Mashiyah/Preventing-Child-Drowning/Book/ProjectBook.pdf

# המרכז האקדמי רופין

## בית-הספר להנדסה המחלקה להנדסת חשמל ומחשבים

## ספר פרויקט גמר לשנת תשע"ט

## נושא הפרויקט:

# מערכת להצלת ילדים מטביעה

מבצעי הפרויקט:
נייד: 054-4929292
רן משיח
ran.mash@gmail.com | :מייל

נייד: 054-7280910
אלכסנדר גזל
sashagezel@gmail.com | :מייל

מנחה הפרויקט:

מר ברגמן אפרים

2

# המרכז האקדמי רופין

## בית-הספר להנדסה המחלקה להנדסת חשמל ומחשבים

## ספר פרויקט גמר לשנת תשע"ט

## נושא הפרויקט:

# מערכת להצלת ילדים מטביעה

הצהרה: העבודה המתוארת במסמך זה היא תוצאה של מחקר אישי שלי. כל טקסט או תוצאה שנלקחו והוכנסו לעבודה זו ממקורות אחרים מתועדים ככאלה. אני יודע/ת שאי עמידה בתנאים )של עבודה עצמית, וציטוט נאות של מקורות( היא עבירה על תקנון המשמעת של בית הספר העשויה לגרור צעדים משמעתיים בפני ועדת המשמעת.

חתימת הסטודנט | תאריך |
חתימת הסטודנט | תאריך |
חתימת המנחה | תאריך |

מבצעי הפרויקט:
נייד: 054-4929292
רן משיח
ran.mash@gmail.com | :מייל

נייד: 054-7280910
אלכסנדר גזל
sashagezel@gmail.com | :מייל

מנחה הפרויקט:

מר ברגמן אפרים

3

## מערכת להצלת ילדים מטביעה

תקציר

מקרי פגיעה ומוות כתוצאה מטביעה, בעיקר של תינוקות ושל ילדים, הפכו לשגרה עצובה בישראל ובעולם. טביעה הינה סיבת התמותה השנייה בשכיחותה בקרב ילדים. טביעות נגרמות בדרך כלל בהעדר השגחה, ואפילו לשניות בודדות. זה יכול לקרות בים או בבריכה.

בשל בעיה חשובה זו הוחלט לפתח מערכת המשלבת חומרה ותוכנה שתדע לזהות מקרה טביעה בקרב ילדים ותיתן מענה מהיר ונכון לצורך הצלת חיי הילד בעת טביעה. המערכת מיועדת לילדים בגילאים 0-8 שאינם יודעים לשחות ולא אמורים להיכנס למים ללא השגחת מבוגר.

המערכת אחראית לזיהוי הטביעה ולהפעלת המנגנונים השונים להצלת הילד במקרה הצורך. המערכת החשמלית כוללת מיקרו בקר, מנוע, מקור מתח, רכיב GSM וחיישנים שונים שינטרו את העומק בו נמצא הילד. כאשר הילד ימצא בעומק מסוים לפרק זמן שהוחלט מראש, המערכת החשמלית תפעיל מנגנונים שונים להצלת הילד.

מנגנון ראשון ודרישה עיקרית מהמערכת, היא היכולת להרים את ראשו של הילד מעל פני המים ולשמור עליו במצב זה. כאשר נענה לדרישה זו נמנע מגע של מים עם דרכי הנשימה שמוביל לחנק. מנגנון שני הוא שליחת הודעת חירום )SMS )למרכז בקרה, שם יתפעלו את האירוע, וישלחו הודעת SMS חזרה להורים. מנגנון זה עונה על הדרישה לקבלת תשומת לב של ההורים. בנוסף קיים גם כפתור לבדיקת תקינות המערכת. בתגובה ללחיצה תשלח הודעת SMS עם דוח תקינות מפורט.

בשלב היישום חוברו כל הרכיבים החשמליים למערכת אחת ונצרב קוד לארדואינו שמממש את הדרישות שהוגדרו. המערכת מזהה מגע עם מים באמצעות 2 פרובים כאשר הם מוכנסים למקור מים, בעקבות זאת המערכת נדלקת ומתחילה לעבד נתונים מהחיישן לחץ / עומק. באמצעות החיישן ניתן למדוד לחץ בדיוק של 0.01% ולחשב את הפרש העומק בו נמצא החיישן. המערכת מבצעת מדידה לחץ, ומתריעה על מצב טביעה ברגע שמתגלה עומק העולה על 10 ס"מ. ולאחר חציית הסף היא מפעילה טיימר של 2 שניות. אם במהלך הטיימר המערכת לא מזהה ירידה מהעומק שהוגדר, היא מפעילה מנוע DC שפותח את הווסת לשחרור ה - 2CO מחסנית ובכך לנפח את בלוני הציפה. המתח הנדרש להפעלת המנוע הוא V6 ולכן נעשה שימוש בממיר מתח, המעלה את מתח סוללת ה -LiPo למתח הדרוש. לאחר ניפוח בלוני הציפה, המערכת שולחת הודעה חירום למרכז בקרה. שליחת הודעות ה - SMS מתבצעת באמצעות רכיב התקשורת הסלולרית. בנוסף לבדיקת תקינות יזומה ע"י לחיצה על כפתור, המערכת מבצעת בדיקת תקינות אוטומטית לרכיבי המערכת בעת הדלקתה. לאחר בדיקת תקינות יזומה או אוטומטית נשלחת הודעת תקינות למרכז בקרה ובנוסף נדלק לד בצבע המתאים לתוצאת הבדיקה. נפח בלוני הציפה חושב באמצעות חוק ארכימדס.

לאחר בדיקות רבות וניסויים ניתן לומר כי המערכת מבצעת את הדרישות שהוגדרו בשלב התכנון. המערכת יודעת לזהות טביעה באחוז דיוק גבוה מאוד. צריכת המערכת הכוללת היא כ - mA 4.5 במצב שינה, וכ - mA15 כאשר המערכת נמצאת במגע עם מים. מכיוון שבמוצר הסופי יש הגבלה על גודל הסוללה, הוחלט כי המערכת תהיה כבויה עד אשר היא תורכב על צוואר הילד. היא תדלק באופן אוטומטי ברגע נעילת סוגר השרשרת. במקרה של תקציב גדול יותר ניתן היה להגיע למוצר מוגמר שניתן יהיה להלביש על הילד.

4

## מערכת להצלת ילדים מטביעה

תוכן עניינים

.1 הקדמה 6 |
.2 סקר ספרות7 |
.2.1 ארדואינו7 |
7 | UART .2.2
C | תקשורת | .2.3 ² 8 | I
9 | GSM .2.4
.2.5 רמת אטימות IP9 |
.2.6 חוק ארכימדס10 |
.2.7 לחץ אטמוספרי11 |
.2.8 בלוני ציפה11 |
.2.9 נפח בלוני ציפה12 |
.2.10 משוואת הגז האידיאלי 13 |
.2.11 פחמן דו חמצני )2CO )14 |
.3.1 דרישות עיקריות 15 |
.3.2 תיאור המערכת17 |
.3.3 מבנה הקוד )אלגוריתם(26 |
.3.4 אתגרים במימוש 30 |
.4.1 המערכת מבצעת בדיקת תקינות כללית לאחר הדלקתה32 |
.4.2 הפעלת פסיקה לבדיקת תקינות המערכת לאחר לחיצה על הכפתור33 |
.4.3 זיהוי מגע עם מים35 |
.4.4 קבלה ועיבוד נתונים מחיישן העומק36 |
.4.5 זיהוי מצב טביעה 37 |
.4.6 ניפוח בלוני ציפה כמנגנון ראשון להצלת התינוק / ילד38 |
.4.7 שליחת הודעות חירום כמנגנון שני להצלת התינוק / ילד39 |
.5.1 תוצאות והישגים40 |
.5.2 המלצות להמשך40 |
42 | ABSTRACT .7
.8.1 נספח :1 קוד המערכת43 |
.8.2 נספח :2 בדיקות המערכת )STD )53 |
.8.3 נספח :3ניהול סיכונים56 |
.8.4 נספח :4גאנט 59 |

5

רשימת תמונות ואיורים

תמונה 1 - חוט TX של UART אחד מתחבר לחוט RX של השני ולהפך. (https://ruppin365-my.sharepoint.com/personal/ran_messia_ruppin365_net/Documents/פרוייקט%20גמר/Final/ProjectBook.docx) 7 | (https://ruppin365-my.sharepoint.com/personal/ran_messia_ruppin365_net/Documents/פרוייקט%20גמר/Final/ProjectBook.docx)
תמונה 2 - UART המשדר בייט מידע (https://ruppin365-my.sharepoint.com/personal/ran_messia_ruppin365_net/Documents/פרוייקט%20גמר/Final/ProjectBook.docx) 7 | (https://ruppin365-my.sharepoint.com/personal/ran_messia_ruppin365_net/Documents/פרוייקט%20גמר/Final/ProjectBook.docx)
8 | I

תמונה 3 - תיאור של אפיק C² (https://ruppin365-my.sharepoint.com/personal/ran_messia_ruppin365_net/Documents/פרוייקט%20גמר/Final/ProjectBook.docx)
תמונה 4 - דרגות ההגנה שמספקות מעטפות (https://ruppin365-my.sharepoint.com/personal/ran_messia_ruppin365_net/Documents/פרוייקט%20גמר/Final/ProjectBook.docx) 9 | (https://ruppin365-my.sharepoint.com/personal/ran_messia_ruppin365_net/Documents/פרוייקט%20גמר/Final/ProjectBook.docx)
תמונה 6 - טווח משקלים של תינוקות וילדים מגיל 5 עד 10 (https://ruppin365-my.sharepoint.com/personal/ran_messia_ruppin365_net/Documents/פרוייקט%20גמר/Final/ProjectBook.docx) 12 | (https://ruppin365-my.sharepoint.com/personal/ran_messia_ruppin365_net/Documents/פרוייקט%20גמר/Final/ProjectBook.docx)
תמונה 7 - תכונות הפחמן הדו חמצני (https://ruppin365-my.sharepoint.com/personal/ran_messia_ruppin365_net/Documents/פרוייקט%20גמר/Final/ProjectBook.docx) 14 | (https://ruppin365-my.sharepoint.com/personal/ran_messia_ruppin365_net/Documents/פרוייקט%20גמר/Final/ProjectBook.docx)
תמונה 8 - מחסנית 2CO 16 גרם14 | (https://ruppin365-my.sharepoint.com/personal/ran_messia_ruppin365_net/Documents/פרוייקט%20גמר/Final/ProjectBook.docx)
תמונה 9 - מבנה חיצוני (https://ruppin365-my.sharepoint.com/personal/ran_messia_ruppin365_net/Documents/פרוייקט%20גמר/Final/ProjectBook.docx) 17 | (https://ruppin365-my.sharepoint.com/personal/ran_messia_ruppin365_net/Documents/פרוייקט%20גמר/Final/ProjectBook.docx)
תמונה 10 - ארכיטקטורה פנימית (https://ruppin365-my.sharepoint.com/personal/ran_messia_ruppin365_net/Documents/פרוייקט%20גמר/Final/ProjectBook.docx) 18 | (https://ruppin365-my.sharepoint.com/personal/ran_messia_ruppin365_net/Documents/פרוייקט%20גמר/Final/ProjectBook.docx)
19 | ARDUINO PRO MINI - 11 | תמונה (https://ruppin365-my.sharepoint.com/personal/ran_messia_ruppin365_net/Documents/פרוייקט%20גמר/Final/ProjectBook.docx)
20 | MS5803-14BA - 12 | תמונה (https://ruppin365-my.sharepoint.com/personal/ran_messia_ruppin365_net/Documents/פרוייקט%20גמר/Final/ProjectBook.docx)
21 | MINI GEARED DC MOTOR 6V - 13 | תמונה (https://ruppin365-my.sharepoint.com/personal/ran_messia_ruppin365_net/Documents/פרוייקט%20גמר/Final/ProjectBook.docx)
תמונה 14 - בקר מנוע DC FNG6612TB (https://ruppin365-my.sharepoint.com/personal/ran_messia_ruppin365_net/Documents/פרוייקט%20גמר/Final/ProjectBook.docx) 22 | (https://ruppin365-my.sharepoint.com/personal/ran_messia_ruppin365_net/Documents/פרוייקט%20גמר/Final/ProjectBook.docx)
22 | SIM800L - 15 | תמונה (https://ruppin365-my.sharepoint.com/personal/ran_messia_ruppin365_net/Documents/פרוייקט%20גמר/Final/ProjectBook.docx)
23 | DC/DC BOOST CONVERTER + CHARGER - 16 | תמונה (https://ruppin365-my.sharepoint.com/personal/ran_messia_ruppin365_net/Documents/פרוייקט%20גמר/Final/ProjectBook.docx)
תמונה 17 - סוללת LIPO V23 | 3.7 (https://ruppin365-my.sharepoint.com/personal/ran_messia_ruppin365_net/Documents/פרוייקט%20גמר/Final/ProjectBook.docx)
תמונה 18 - טעינה אלחוטית24 | (https://ruppin365-my.sharepoint.com/personal/ran_messia_ruppin365_net/Documents/פרוייקט%20גמר/Final/ProjectBook.docx)
תמונה 19 - המערכת מבצעת בדיקת תקינות כללית לאחר הדלקתה - תקין32 | (https://ruppin365-my.sharepoint.com/personal/ran_messia_ruppin365_net/Documents/פרוייקט%20גמר/Final/ProjectBook.docx)
תמונה 20 - קבלת הודעת SMS למרכז בקרה שהכל תקין33 | (https://ruppin365-my.sharepoint.com/personal/ran_messia_ruppin365_net/Documents/פרוייקט%20גמר/Final/ProjectBook.docx)
תמונה 21 - המערכת מבצעת בדיקת תקינות כללית לאחר הדלקתה - לא תקין (https://ruppin365-my.sharepoint.com/personal/ran_messia_ruppin365_net/Documents/פרוייקט%20גמר/Final/ProjectBook.docx) 33 | (https://ruppin365-my.sharepoint.com/personal/ran_messia_ruppin365_net/Documents/פרוייקט%20גמר/Final/ProjectBook.docx)
תמונה 22 - בדיקת תקינות המערכת לאחר לחיצה על הכפתור (https://ruppin365-my.sharepoint.com/personal/ran_messia_ruppin365_net/Documents/פרוייקט%20גמר/Final/ProjectBook.docx) 34 | (https://ruppin365-my.sharepoint.com/personal/ran_messia_ruppin365_net/Documents/פרוייקט%20גמר/Final/ProjectBook.docx)
תמונה 23 - הודעת SMS לאחר לחיצה על הכפתור הבדיקות34 | (https://ruppin365-my.sharepoint.com/personal/ran_messia_ruppin365_net/Documents/פרוייקט%20גמר/Final/ProjectBook.docx)
תמונה 24 - זיהוי מגע עם מים35 | (https://ruppin365-my.sharepoint.com/personal/ran_messia_ruppin365_net/Documents/פרוייקט%20גמר/Final/ProjectBook.docx)
תמונה 25 - קבלה ועיבוד נתונים מחיישן העומק (https://ruppin365-my.sharepoint.com/personal/ran_messia_ruppin365_net/Documents/פרוייקט%20גמר/Final/ProjectBook.docx) 36 | (https://ruppin365-my.sharepoint.com/personal/ran_messia_ruppin365_net/Documents/פרוייקט%20גמר/Final/ProjectBook.docx)
תמונה 26 - זיהוי מצב טביעה לאחר שנגמר הטיימר37 | (https://ruppin365-my.sharepoint.com/personal/ran_messia_ruppin365_net/Documents/פרוייקט%20גמר/Final/ProjectBook.docx)
תמונה 27 - ניפוח בלוני ציפה כמנגנון ראשון להצלת התינוק / ילד38 | (https://ruppin365-my.sharepoint.com/personal/ran_messia_ruppin365_net/Documents/פרוייקט%20גמר/Final/ProjectBook.docx)
תמונה 28 - שליחת הודעות חירום כמנגנון שני להצלת התינוק / ילד39 | (https://ruppin365-my.sharepoint.com/personal/ran_messia_ruppin365_net/Documents/פרוייקט%20גמר/Final/ProjectBook.docx)
תמונה 29 - הודעות החירום המתקבלות (https://ruppin365-my.sharepoint.com/personal/ran_messia_ruppin365_net/Documents/פרוייקט%20גמר/Final/ProjectBook.docx) 39 | (https://ruppin365-my.sharepoint.com/personal/ran_messia_ruppin365_net/Documents/פרוייקט%20גמר/Final/ProjectBook.docx)

רשימת טבלאות

טבלה 1 - גיל, משקל ממוצע ונפח הבלון הדרוש13 |
טבלה 2 - צפיפות לפי סוג החומר13 |
טבלה 3 - מאפייני המיקרו בקר מתוך דף המפרט (https://ruppin365-my.sharepoint.com/personal/ran_messia_ruppin365_net/Documents/פרוייקט%20גמר/Final/ProjectBook.docx) 19 | (https://ruppin365-my.sharepoint.com/personal/ran_messia_ruppin365_net/Documents/פרוייקט%20גמר/Final/ProjectBook.docx)
טבלה 4 - מאפייני החיישן מתוך דף המפרט20 | (https://ruppin365-my.sharepoint.com/personal/ran_messia_ruppin365_net/Documents/פרוייקט%20גמר/Final/ProjectBook.docx)
טבלה 5 - מאפייני המנוע מתוך דף המפרט21 | (https://ruppin365-my.sharepoint.com/personal/ran_messia_ruppin365_net/Documents/פרוייקט%20גמר/Final/ProjectBook.docx)
טבלה 6 - מאפייני בקר המנוע מתוך דף המפרט22 | (https://ruppin365-my.sharepoint.com/personal/ran_messia_ruppin365_net/Documents/פרוייקט%20גמר/Final/ProjectBook.docx)
טבלה 7 - מאפייני רכיב ה - GSM מתוך דף המפרט22 | (https://ruppin365-my.sharepoint.com/personal/ran_messia_ruppin365_net/Documents/פרוייקט%20גמר/Final/ProjectBook.docx)
טבלה 8 - מאפייני רכיב ה ממיר מתח + מטען סוללות מתוך דף המפרט23 | (https://ruppin365-my.sharepoint.com/personal/ran_messia_ruppin365_net/Documents/פרוייקט%20גמר/Final/ProjectBook.docx)

רשימת משוואות

משוואה 1 - כוח העילוי10 |
משוואה 2 - הכוח השקול על גוף10 |
משוואה 3 - משוואת הגזים האידאלי 13 |
משוואה 4 - נפח הגז הנפלט ממחסנית 16 גרם14 |
משוואה 5 - חישוב שינוי בגובה30 |

6

.1 הקדמה

טביעה מכונה "המוות השקט", היא מתרחשת במהירות ובדממה ובדרך כלל לא שומעים בכי או צעקות מצוקה. מקרי פגיעה ומוות כתוצאה מ"המוות השקט", בעיקר של תינוקות ושל ילדים, הפכו
1 | לשגרה עצובה בישראל ובעולם. טביעה הינה סיבת התמותה השנייה בשכיחותה בקרב ילדים
כשליש ממקרי הטביעה שהסתיימו במוות, היו של ילדים בגילי .4-0 מאז שנת 2008 מתו בישראל .

מעל 210 ילדים עקב טביעה²

מקובל לחשוב כי טביעות מתרחשות רק במים עמוקים, אך למעשה מרבית הטביעות נגרמות בלי קשר לעומק המים. גם בגובה עשרה סנטימטר ילד יכול לטבוע, אם פיו ואפו נמצאים מתחת לפני המים. אצל ילדים ולעיתים גם אצל מבוגרים, מגע של מים עם דרכי הנשימה מוביל להתכווצות של שרירי הלוע, דבר שבעצמו סוגר את דרכי הנשימה ומוביל לחנק.

הנזק העיקרי מטביעה הוא המחסור בחמצן - מצב המכונה היפוקסמיה. מצב זה גורם לנזק לכל רקמות הגוף, אולם רקמת המוח רגישה במיוחד למחסור בחמצן ולכן, הנזק המוחי הוא הגורם העיקרי לתחלואה ולתמותה כתוצאה מטביעה.

טביעות נגרמות בדרך כלל בהעדר השגחה, ואפילו לשניות בודדות. זה יכול לקרות בים, בבריכה העירונית, בבריכה הפרטית בבית, או במלון. נמצא כי תשעה מכל עשרה מקרי טביעה של ילדים התרחשו כשההורים היו בקרבת ילדיהם ולעיתים אף צמודים להם ממש.

למרות אמצעי הבטיחות הקיימים למניעת טביעות ומקרי מוות בקרב תינוקות וילדים, מקרים אלו נעשו שכיחים יותר מאשר בעבר. בשל בעיה חשובה זו הוחלט לפתח מערכת המשלבת חומרה ותוכנה שתדע לזהות מקרה טביעה בקרב ילדים ותיתן מענה מהיר ונכון לצורך הצלת חיי הילד בעת טביעה.

משרד הבריאות - בטיחות ילדים במים ומניעת טביעה | 1
היפגעות ילדים בישראל: דו"ח 'בטרם' לאומה 2017 | 2

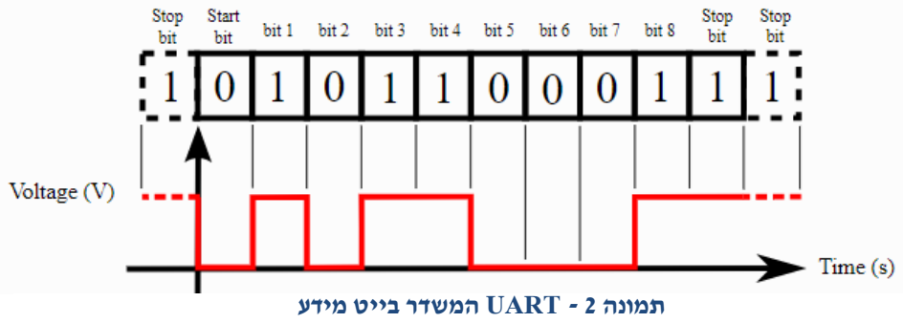
[picture p22: figure]
תמונה 2 - UART המשדר בייט מידע

7

.2 סקר ספרות

.2.1 ארדואינו

אַ רְ דּואִ ינֹו )מאיטלקית: Arduino )הוא מיקרו-בקר בעל מעגל מודפס יחיד, עם סביבת פיתוח משולבת )IDE )ברישיון קוד פתוח, אשר מטרתה ליצור סביבה נוחה וזולה לפיתוח פרויקטים המשלבים תוכנה עם רכיבי אלקטרוניקה.

רכיב החומרה העיקרי על המעגל המודפס של הארדואינו הוא מיקרו בקר בן 8 סיביות מסדרת AVR של חברת ATMEL, אשר מבצע את התוכנה ומכיל זיכרון הבזק )FlashMemory )לאחסונה. לארדואינו גרסאות חומרה שונות למטרות שונות. הוא מגיע בגדלים שונים, מתחי עבודה שונים וגם תדר שעון שונה.

לארדואינו יש את היכולת לתקשר עם רכיבים חיצוניים ומודולים באמצעות פרוטוקולים סטנדרטיים שהופכים את התקשורת לפשוטה ואמינה ויותר - פרוטוקולים SPI, C2I ו-UART.

UART .2.2

UART( מבוטא "יּו - אַ רט"( הוא פרוטוקול תקשורת נפוץ לתקשורת טורית אסינכרונית. מקור השם באנגלית בראשי תיבות של Receiver Asynchronous Universal Transmitter, ובעברית "מקלט משדר אסינכרוני אוניברסלי" שהתייחס אל השבב אשר מימש את פרוטוקול התקשורת הטורית. מערכות רבות מממשות את הפרוטוקול כחלק ממעגל משולב או בתוך רכיב מתכנת. הפרוטוקול מאפשר תקשורת טורית עם 2 חוטים בלבד )Tx ו - Rx) הפרוטוקול נותן שליטה על מספר פרמטרים כמו קצב העברת הנתונים, כמות סיביות המידע בכל, הוספת סיבית זוגיות ומשך סימבול הסיום.

תמונה 1 - חוט TX של UART אחד מתחבר לחוט RX של השני ולהפך.

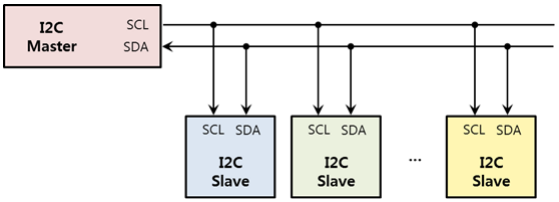
[picture p23: figure]

8

C | תקשורת | .2.3 ² I
C-BUS או , | אפיק ² C - Circuit Integrated-Inter( I

2
I(, ידוע גם בשם "ממשק שני-
מוליכים" הוא ממשק תקשורת טורית )סריאלי( המורכב משני מוליכים. הממשק נועד, במקורו, להעברת נתונים בין רכיבים במעגלים מוכללים שהותקנו במכשירי רדיו וטלויזיה. כיום, השימוש העיקרי באפיק זה הוא כממשק תקשורת בין מיקרו-מעבד )או מיקרו-בקר( לבין רכיבי קצה. מהירויות העבודה האופייניות של הרכיב הן kbps .100-3400
2 | תקן )פרוטוקול( C
I מגדיר את נוהל התקשורת בין הרכיבים המחוברים לאפיק, לרבות

תדר שידור המידע )data), תזמון התקשורת בין הרכיבים ומבנה יחידת המידע המשודרת. שני המוליכים באפיק הם דו-כיווניים ולכל אחד מהם תפקיד מוגדר:

- קו מידע )SDA-DataSerial )שנועד להעברת מידע בין רכיבים. כל אחד מהרכיבים המחוברים לאפיק זה יכול לשמש כמשדר או כמקלט.
- קו שעון )SCL-ClockSerial )שנועד לסנכרן את המידע העובר בין רכיבים.

יחידת המידע הבסיסית המשודרת מרכיב לרכיב היא מילה באורך של 8 סיביות. לכל אחד מהרכיבים המחוברים לאפיק משויכת כתובת הנקבעת על-ידי סוג הרכיב המחובר )מיקרו-בקר, חיישן, התקן זיכרון(.

התקן מגדיר שני סוגי רכיבים שניתן לחבר לאפיק רכיבי MASTER ורכיבי SLAVE.

רכיב MASTER מוגדר כרכיב שיוזם את התקשורת ומספק את אות השעון. הרכיב שאליו

פונה ה - MASTER מוגדר כרכיב ה - SLAVE. בדרך כלל ה - MASTER הוא מיקרו-

בקר )או מיקרו-מעבד(, בעוד שה - SLAVE הוא רכיב קצה כדוגמת, חיישן, רכיב תצוגה, התקן זיכרון וממיר ספרתי לאנלוגי.

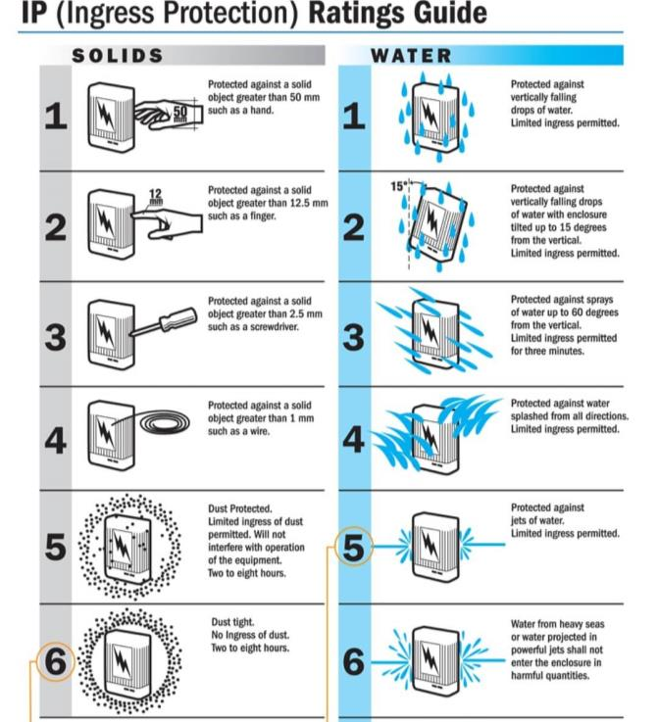
[picture p24: figure]

9

תמונה 4 - דרגות ההגנה שמספקות מעטפות

GSM .2.4

תקשורת | לרשתות | תקן | הוא | Global System for Mobile Communications או GSM
סלולרית. רשתות אלו הן הנפוצות ביותר בעולם. ב־2010 היו בעולם כחמישה מיליארד מנויי GSM.

GSM עושה שימוש בטכנולוגית גישה מרובה מבוססת זמן, Multiple Division Time Access. הקול מועבר באופן דיגיטלי ולכן רשתות GSM מקוטלגות כ-"דור שני". הרשת הבסיסית שמותאמת לשיחות קוליות בלבד הורחבה באמצעות שתי טכנולוגיות משלימות להעברת נתונים: GPRS ו-EDGE. טכנולוגיות אלו מכונות "דור 2.5" ו-"דור 2.75" בהתאמה.

GSM תומך בטווח רחב של תדרים. באופן כללי בטווח שבין MHz 260 ל- MHz .1900 GSM מגדיר לא רק את ממשק השיחה אלא את התשתית כולה, זאת כדי לאפשר תאימות בין יצרנים שונים וכן לאפשר ממסר בין תחנות ונדידה - קבלת שירות עבור המכשיר או כרטיס ה-SIM בין מדינות שונות.

.2.5 רמת אטימות IP

רמת אטימות IP( גם דרגת IP (קיצור שלMarking Protection International היא סיווג של מידת ההגנה והאטימות של מכשיר מסוים מפני חלקיקים )אבק( ומפני מים. הסיווג מורכב מצמד האותיות האנגליות IP ומשתי ספרות, המוגדרות על ידי תקן 60529 IEC של הנציבות הבינלאומית לאלקטרוטכניקה.

הספרה הראשונה מציינת הגנה נגד מגע מקרי או מגע רשלני בחלקים חיים או נעים בתוך המעטפת וגם חדירת גופים מוצקים לתוך המעטפת. הספרה שנייה מציינת את דרגת הגנה מפני חדירת מים, דרך המעטפת.

לדוגמא:
68IP מציין הגנה מוחלטת מפני חדירת אבק ובנוסף הגנה בפני חדירת מים בעת ממושכת,
בתנאים שפרט היצרן.

10

.2.6 חוק ארכימדס

כאשר גוף נמצא בנוזל, הוא עשוי לצוף על פני הנוזל או לשקוע בתוכו. החוק מראה כי הגוף צף אם הצפיפות שלו ) היחס בין מסתו לנפחו ( קטנה מזו של הנוזל . אם הצפיפות של הגוף גדולה מצפיפות הנוזל, הגוף שוקע. אם הצפיפויות שוות, הגוף ירחף בנוזל, כלומר ישהה בגובה שבו נשים אותו.

קל להסביר את הממצאים הללו בעזרת תכונות הלחץ ההידרוסטטי. כאשר הגוף נמצא בתוך הנוזל פועל עליו לחץ הידורו סטטי מכל הצדדים. אולם מכיוון שהלחץ גדל עם העומק, הלחץ ההידרוסטטי על צידו התחתון של הגוף גדול יותר מאשר על צידו העליון. לכן פועל על הגוף כוח שקול בכיוון מעלה, המכונה כוח עילוי .

את גודלו של כוח העילוי נחשב כך: נניח שאת מקום הגוף הייתה תופסת כמות של נוזל, שנפחה וצורתה זהים לאלה של הגוף. הנוזל מסביב היה מפעיל עליה כוחות זהים לאלה שהוא מפעיל על הגוף. מכיוון שכמות הנוזל הייתה נמצאת במנוחה, אפשר להסיק כי השקול של הכוחות הללו שווה בגודלו למשקל של כמות הנוזל, שהוא כידוע כוח בגודל, mg שכיוונו כלפי מטה. מכאן שכוח העילוי על הגוף הוא, mg כאשר m היא המסה של כמות נוזל, שנפחה שווה לנפח הגוף. אם נפח הגוף הוא, V וצפיפות הנוזל היא ρ , נקבל Vρ = m כוח העילוי נתון לכן על ידי: F = Vρg

כאשר V הוא נפח הגוף ו - ρ היא צפיפות הנוזל.

ארכימדס, שחי במאה השלישית לפנה"ס, גילה חוק זה לראשונה וניסח אותו כך: ''על גוף השקוע בנוזל פועל כוח עילוי השווה למשקל הנוזל שנדחה על ידי הגוף. ''

עלינו לזכור כי על הגוף פועל גם משקלו שלו , ולכן הכוח השקול הוא: ∑F = Vρg − Vρ
′g = Vg − Vg(ρ − ρ

′
)

ρ היא צפיפות הנוזל ו ′ρ היא צפיפות הגוף.

אם ρ > ′ρ, כוח העילוי גובר על המשקל והכוח השקול מכוון כלפי מעלה. הגוף יצוף עד שחלקו יבצבץ מהמים, באופן שכוח העילוי על החלק השקוע יאזן את משקל הגוף כולו. אם ρ < ′ρ, המשקל גובר על כוח העילוי והגוף ישקע עד לקרקעית.

אם ρ = ′ρ, כוח העילוי שווה למשקל והגוף ירחף.

משוואה 1 - כוח העילוי

משוואה 2 - הכוח השקול על גוף

11

.2.7 לחץ אטמוספרי

לעיתים נקרא גם לחץ ברומטרי הוא הלחץ, שמפעיל האוויר באטמוספירה של כדור הארץ. גודלו של הלחץ האטמוספירי הממוצע בגובה פני הים הוא:

בקירוב, ניתן לומר, כי הלחץ האטמוספירי שקול ללחץ ההידרוסטטי, שמפעיל עמוד האוויר מעל כל נקודה בכדור הארץ. כך, מעל אזורי לחץ נמוך עמוד האוויר נמוך יותר מאשר באזורי לחץ גבוה. באופן דומה, ניתן להבין מדוע לחץ האוויר יורד, ככל שעולים גבוה יותר מעל פני הים.

הבדלים בלחץ האוויר נוצרים מהבדלים בקרינת השמש, בגובה ובקו הרוחב של האזור. המכשיר המודד לחץ אוויר נקרא ברומטר, ויחידות המידה בהן משתמשים למטרה זו הן מ"מ כספית (Hmm) או בר (ab) או אטמוספירה (TA)

.2.8 בלוני ציפה

רוב יצרני סירות הגומי או אביזרים מתנפחים מייצרים את סירותיהם מבד ניילון מצופה פוליאוריתן )TPU). שילוב חומרים זה חזק, אטום לאוויר, עמיד למים, עמיד בפני קרינה אּולְטְ רָ ה סגולה, אינו נמתח הרבה ושומר על חוזקו גם בטמפרטורות נמוכות מאוד.

פוליאוריתן תרמו-פלסטי )TPU )הוא גרסה של PU הנקשרת לעצמה כשהיא מחוממת עם אקדח ברזל או אוויר חם. זה יוצר קשר חזק מאוד וקבוע, ומבטל את הצורך בתפירה או הדבקה.

אחת הדרכים לסיווג הבד היא על ידי (D" (denier", שהוא מדד למשקל החוט, כאשר denier אחד שווה למשקל של חוט משי בודד, ומספרים של denier גבוהים יותר מציינים חוט כבד יותר )ולכן עבה וחזק יותר(. הקשר בין מספר denier למשקל וחוזק הבד אינו לינארי.

לאחר קריאה ממושכת באינטרנט מצאנו כי עובי הבד הנכון לשימוש הוא D210 כיוון שהוא ממש קל, מאפשר לקפל אותו, לא יקרע / ינוקב בקלות ומשתמשים בו רבות באביזרי ציפה למיניהם.

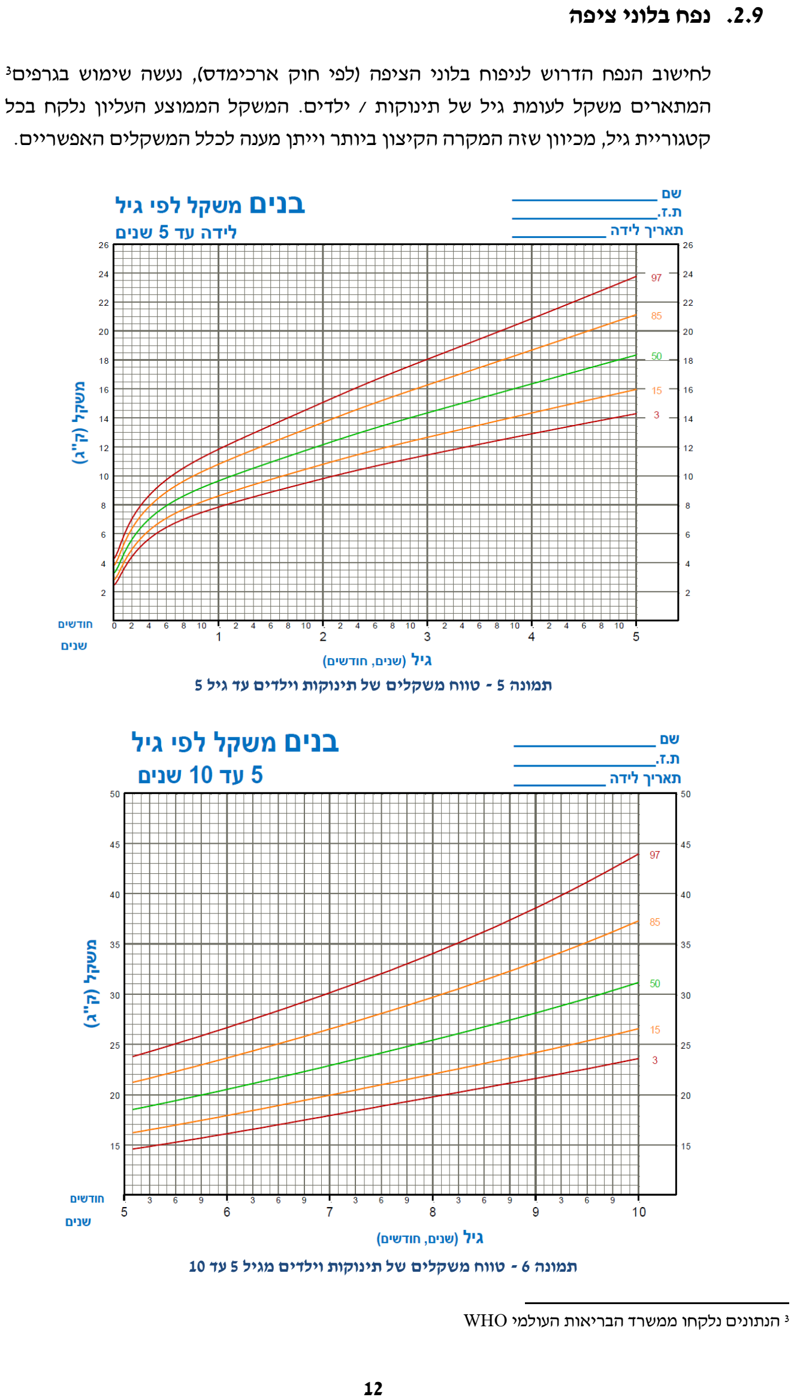
[picture p25: page 12]

12

.2.9 נפח בלוני ציפה

3 | לחישוב הנפח הדרוש לניפוח בלוני הציפה )לפי חוק ארכימדס(, נעשה שימוש בגרפים
המתארים משקל לעומת גיל של תינוקות / ילדים. המשקל הממוצע העליון נלקח בכל קטגוריית גיל, מכיוון שזה המקרה הקיצון ביותר וייתן מענה לכלל המשקלים האפשריים.
הנתונים נלקחו ממשרד הבריאות העולמי WHO | 3

תמונה 5 - טווח משקלים של תינוקות וילדים עד גיל 5

תמונה 6 - טווח משקלים של תינוקות וילדים מגיל 5 עד 10

13

מגרפים הנ"ל ניתן לבנות את הטבלה הבאה:

נפח הבלון הדרוש )2 הבלונים ביחד( | משקל ממוצע )ק"ג, קיצון עליון( | גיל )שנים(
0.52 | 11.8 | 1
0.72 | 15 | 2
0.86 | 18 | 3
0.99 | 20.8 | 4
1.15 | 24 | 5
1.28 | 26.8 | 6
1.43 | 30 | 7
1.62 | 34 | 8
טבלה 1 - גיל, משקל ממוצע ונפח הבלון הדרוש

לחישוב נפח הבלון הדרוש נעשה שימוש בנוסחת ארכימדס )משוואה 2( ובנתונים הבאים:

.2.10 משוואת הגז האידיאלי

גז אידאלי הינו גז אשר מורכב ממולקולות נקודתיות בעלי נפח זניח, שאינן מגיבות זו עם זו. הנחה זו הינה הכרחית לחישובים פשוטים של טמפרטורה, לחץ ונפח הגז. משוואת הגז האידאלי מורכבת משלושה חוקים חשובים: חוק בויל, חוק צ'ארלס וחוק הגז המשולב. שלושת החוקים הללו מגדירים את הקשר בין נפח, לחץ וטמפרטורה של הגז.

חוק בויל מגדיר את הקשר בין לחץ לנפח. ככל שהנפח גדל, הלחץ קטן משום שההסתברות של מולקולות הגז להתנגש בדפנות הכלי יורד. חוק צ'ארלס מגדיר את הקשר בין טמפרטורה לנפח. ככל שהטמפרטורה עולה, גם הנפח עולה, משום שמולקולות הגז מקבלות אנרגית חום המתורגמת לאנרגיה קינטית הגורמת להן לנוע מהר יותר, והלחץ גדל. כאשר הלחץ גדל, הוא מאפשר את הגדלת הנפח על חשבון הלחץ. חוק הגז המשולב משלב בין שני החוקים הנ"ל ומראה את יחסי הגומלין בין טמפרטורה, לחץ ונפח. וחוק הגזים האידאליים מכניס את החוקים הללו למשוואה:

V =

nRT
P

כאשר P - לחץ, T - טמפ', V - נפח, R - קבוע הגזים ) 0.082

L×atm
K×mol

(, n - מספר המולים

Human Body Density and Fat ⁴ The American Journal of Clinical Nutrition -

| סוג חומר צפיפות
g cm³ | מי בריכה 1
g cm³ | מי ים 1.03
g 40.985 cm³ | גוף האדם

טבלה 2 - צפיפות לפי סוג החומר

משוואה 3 - משוואת הגזים האידאלי

14

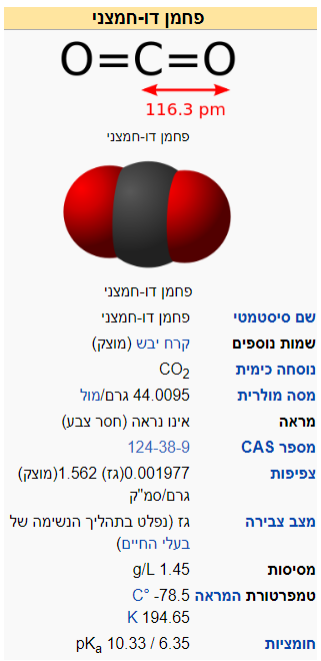
[picture p26: figure]

תמונה 7 - תכונות הפחמן הדו חמצני

.2.11 פחמן דו חמצני )2CO)

פחמן דו חמצני, נקרא גם דו-תחמוצת הפחמן, הוא גז )בטמפרטורת החדר( המהווה תרכובת של פחמן וחמצן. כל מולקולה שלו מורכבת מאטום פחמן אחד ושני אטומי חמצן, הקשורים אליו בקשר קוולנטי כפול. זהו גז חסר צבע אשר מצב הצבירה שלו קרוי קרח יבש, בזכות תכונת ההמראה המאפיינת אותו, כלומר מעבר ישיר ממצב מוצק למצב גז.
. שכיחותו באטמוספירה נמוכה - רק 0.035 | 5 | בעל מסה מולרית של 44.0095 גרם/מול
אחוזים. פחמן דו חמצני הוא התחמוצת המצויה ביותר בעולם.

לצורך מילוי בלוני הציפה, נדרש גז שניתן לאחסן ולטפל בו בקלות. כמו כן, הוא חייב להיות בטוח לשימוש ולא נפיץ. לאחר סקירת ספרות בחרנו בפחמן דו חמצני כגז שימלא את בלוני הציפה מכיוון שצפיפותו היא מאוד נמוכה ביחס לגזים האחרים. בנוסף זה גז שמאוכסן במחסנית במצב נוזל, ככה שבעת שחרורו הוא תופס הרבה יותר נפח כגז.

מחסניות ה - 2CO משמשות למגוון רחב של שימושים כגון: נשקי איירסופט / פיינטבול, ניפוח בלוני ציפה בעלי נפח משתנה וכל המשקאות המוגזים כגון סודה-סטרים.

לחישוב כמות הגז המשתחררת בעת פתיחת המחסנית משתמשים במשוואת הגז האידיאלי. לדוגמא עבור מחסנית 2CO בגודל 16 גרם נקבל:

V =

nRT
P

=

16
44.0095 × 0.082 × 295.4
1.06351 | = 8.2[L]

כאשר T הוא הטמפ' הממוצעת השנתית בים ו - P הוא הלחץ בעומק 0.5 מטר.

5

מול )Mole )הוא יחידת מידה סטנדרטית המגדירה כמות חומר על פי מספר חלקיקים קבוע.

תמונה 8 - מחסנית 2CO 16 גרם

משוואה 4 - נפח הגז הנפלט ממחסנית 16 גרם

15

.3 תכנון הנדסי

.3.1 דרישות עיקריות

דרישה עיקרית מהמערכת, היא היכולת להרים את ראשו של הילד מעל פני המים ולשמור עליו במצב זה. כאשר יינתן מענה לדרישה זו יימנע מגע של מים עם דרכי הנשימה שמוביל לחנק.

דרישה זו נובעת בגלל שראשם של תינוקות וילדים עד גיל 5 כבד יותר משאר חלקי הגוף. זאת הסיבה שילדים מתהפכים ונותרים עם הראש בתוך המים, מבלי יכולת עצמאית להתהפך. אם פיו ואפו של הילד נמצאים מתחת לפני המים לזמן של שתי דקות הוא עלול לאבד את הכרתו, ולאחר מכן קיים סיכון של נזק מוחי בלתי הפיך ועד למוות.

דרישה עיקרית נוספת מהמערכת היא שליחת הודעת SMS להורים על ידי מרכז בקרה, לקבלת תשומת הלב שלהם. דרישה זו נובעת מכיוון שהסיבה העיקרית לטביעת תינוקות וילדים היא העדר השגחה או נתק קצר בהשגחה. יש גורמים רבים המסיחים את דעת ההורים ופוגעים במידת השגחתם על ילדיהם, כמו קריאה, שיחה עם אנשים וכמובן גם שימוש בטלפונים ניידים.

.3.1.1 דרישות ספציפיות

דרישות חיצוניות - המערכת כולה צריכה להיות קלה ונוחה לשימוש מכיוון שמדובר בפריט לביש שמיועד לשבת על צוואר הילד. מכך עולה הדרישה להשתמש בחומרים קלים שלא יכבידו על צוואר הילד. בנוסף החומרים צריכים להיות עמידים למים וכמובן לשימוש הילדים והורים. בנוסף המערכת מיועדת להיות במגע עם מים בעת שימוש, באזורי בריכה או ים, לכן קיימת דרישה שהמערכת החשמלית תהיה במארז עמיד למים )67IP). מארז זה יתן גם מענה לתנאי מזג אוויר קיצוניים אשר עלולים להשפיע על החומרה ולפגוע בה.

דרישות פנימיות - המערכת החשמלית חייבת להיות כמה שיותר אמינה ולפעול עם כמה שפחות תקלות. כלומר צריך לבחור רכיבים חשמליים שהוכיחו את אמינותם ודיוקם בפרויקטים אחרים ובשוק הכללי. רכיבי המערכת החשמלית צריכים להיות כמה שיותר קטנים וקלים כדי שהמוצר כולו יהיה נוח ולא כבד מידי לילד.
בנוסף המערכת החשמלית תקבל מתח ע"י סוללה )V3.7 LiPo )קטנה ולכן הרכיבים בה, יהיו רכיבים בעלי צריכת אנרגיה נמוכה ככל הניתן. הדרישה היא שהמערכת תוכל לעבוד ללא טעינה כשבוע ימים כאשר היא דלוקה )מצב שינה(.

16

דרישות פונקציונליות )תוכנה( -

- בדיקת תקינות המערכת באופן אוטומטי בעת הדלקת המערכת. במטרה לבדוק את תקינות הרכיבים, התקשורת ביניהם ואת אחוז הסוללה. להגיב בהתאם לנדרש לאחר הבדיקות.
- מצב שינה: בעת הדלקת המערכת לאחר בדיקת התקינות, היא תכנס למצב שינה. ובכך צריכת אנרגיה נמוכה ע"י זמן שינה ארוך ככל האפשר.
- קבלה ועיבוד נתוני החיישנים: תקשורת רציפה ואמינה בין המיקרו-בקר לחיישן המים והעומק ובנוסף לרכיב GSM.
- זיהוי עומק סף: כתיבת אלגוריתם לזיהוי עומק שיוגדר מראש ובדיקה אם הערך שהתקבל אחרי ניתוח של תוצאות החיישנים על ידי הארדואינו חוצה את הסף.
- הפעלת טיימר לזמן מוגדר מראש שיבדוק אם הילד לא יוצא מהעומק סף במסגרת הזמן הזה.
- אם זוהתה טביעה, יופעל המנוע לסיבוב הווסת במטרה לשחרר את הגז מהמחסנית ובכך למלא את בלוני הציפה.
- שליחת הודעת SMS למרכז הבקרה על מקרה הטביעה, על מנת שיוכלו לפעול במהירות לשליחת הגורמים הרלוונטיים )הורים, כוחות הצלה( למיקום האירוע.
- בדיקת תקינות המערכת באופן יזום על ידי לחיצה על כפתור בדיקת תקינות. במטרה לבדוק את תקינות הרכיבים, התקשורת ביניהם ואת אחוז הסוללה. להגיב כנדרש לאחר הבדיקות.
- מבחינת עיצוב תוכנה ומבחינת קוד צריכה להיות בנויה וכתובה בצורה ג'נרית ומודולרית, כך שתאפשר מרחב ומערך שיפורים עתידיים.

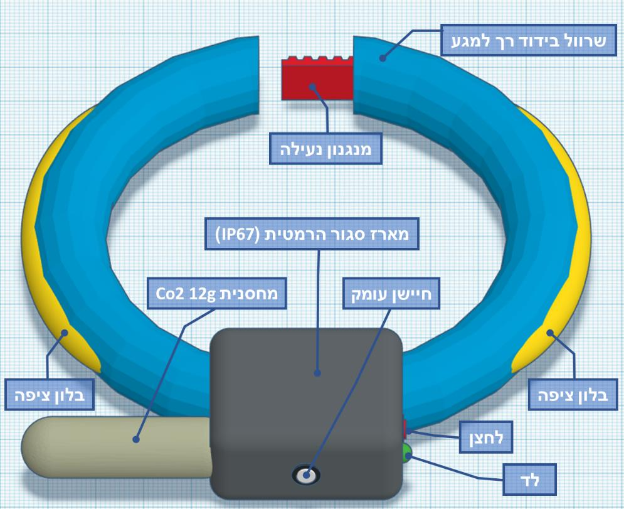
[picture p27: figure]

17

.3.2 תיאור המערכת

.3.2.1 מבנה חיצוני

המוצר הסופי יהיה בנויה בצורת שרשרת אשר יולבש על צוואר הילד. משני צידי השרשרת יהיו בלוני ציפה מקופלים לתוך השרשרת עצמה. לשרשרת יחובר מארז עמיד למים )67IP )ובתוכה תהיה מערכת חשמלית.

- המערכת החשמלית תדלק כאשר מנגנון הנעילה נסגר, ככה יימנע מצב שבו ההורים שוכחים להדליק את המערכת.
- כפי שצוין בחלק סקר הספרות )2.9( בלוני הציפה יהיו מבד עמיד מצופה פוליאוריתן )TPU). בלוני הציפה יהיו בנפח 1 ליטר בכל צד, לפי שצוין בחלק סקר הספרות )2.9(
- כפתור ההדלקה וכפתור בדיקת התקינות יהיו כפתורים עמידים למגע עם מים.
- השרשרת עצמה תהיה מורכבת משרוול בידוד דק, קל ורך למגע. זהו חומר לא דליק, לא רעיל ובעל ספיגת מים מזערית. חומר זה משמש לבידוד צינורות נחושת במערכות קירור וחימום.
- כפי שצוין בחלק סקר הספרות )2.6( ו- )2.8( נעשה שימוש במחסנית 2CO בגודל 16 גרם במטרה לנפח את 2 בלוני הציפה.

תמונה 9 - מבנה חיצוני

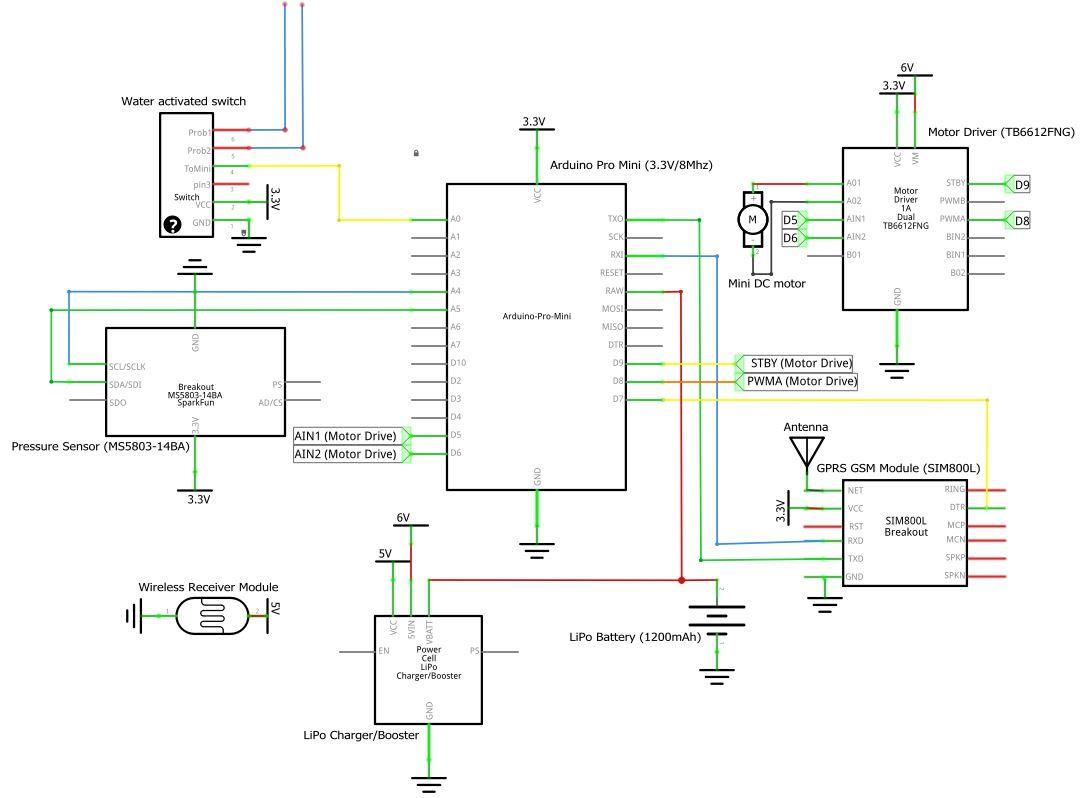
[picture p28: figure]

18

.3.2.2 מבנה פנימי

המערכת משלבת חומרה שנבחרה בקפידה כדי לבצע בצורה טובה ואמינה את המטרות והדרישות שהוגדרו. המערכת החשמלית תהיה אחראית לזיהוי הטביעה ולהפעלת המנגנונים השונים להצלת הילד במקרה הצורך.

* מלבד זאת נמצאים במעגל גם לחצן הדלקה/כיבוי ולחצן בדיקת תקינות, נגדים ו - LED.

תמונה 10 - ארכיטקטורה פנימית

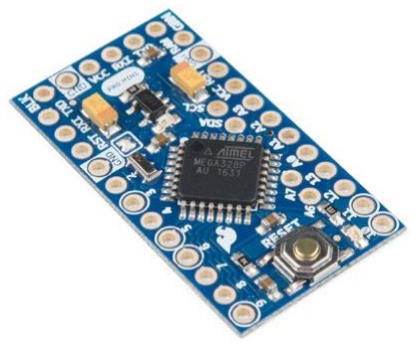
[picture p29: figure]

19

.3.2.3 פירוט הרכיבים החשמליים במערכת החשמלית

מיקרו-בקר

כל הרכיבים החשמליים יהיו מחוברים ליחידת מיקרו-בקר. בפרויקט זה הוחלט לעבוד עם ארדואינו כי הוא כלי פיתוח ופלטפורמה בקוד פתוח שכולל סביבת פיתוח קלה ונוחה למשתמש.

בפרויקט נעשה שימוש ברכיבים כמה שיותר קטנים, בעלי משקל נמוך ובעלי צריכה אנרגיה נמוכה. כלומר קיים צורך להשתמש במיקרו-בקר שיהיה קטן, קומפקטי וחסכוני באנרגיה.

אופציה עיקרית שעונה על צרכי הפרויקט הן מבחינת מקום וכן מבחינת חסכון באנרגיה היא הארדואינו פרו-מיני )Mini Pro Arduino[ )או חיקויים דומים במבנה וביכולות[.

הוא כולל את כל החיבורים הדרושים לנו לחיבור שאר הרכיבים החשמליים.

* ACT - Active Mode
* PDS - Power-Down Sleep with Watchdog Timer enabled
Arduino Pro Mini - 11 | תמונה
Name | Arduino Pro Mini
Microcontroller | ATmega328
Operating Voltage | 3.3 V
Input Voltage (recommended) | 3.3 -12 V
Digital I/O Pins | 14
PWM Channels | 6
Analog Input Channels | 8
DC Current per I/O Pin | 40 mA
Flash Memory | 32 KB
SRAM | 2 KB
Clock Speed | 8 MHz
Power Consumption | ACT - 5 mA, PDS - 0.9 mA
Length | 33 mm
Width | 18 mm
Weight | 2 g

טבלה 3 - מאפייני המיקרו בקר מתוך דף המפרט

20

חיישן לחץ / עומק )Sensor Pressure Altimeter)

חיישן העומק צריך לקיים כמה דרישות:

- תחום עבודה )range Pressure )- בפרויקט זה לא דרושה עמידה בלחצים גבוהים )עומק רב( מכיוון שמטרת הפרויקט הינה הצלת ילדים מטביעה בבריכה או בים. כלומר תחום העבודה הדרוש הוא עד ±5 מטר. אין לנו צורך בחיישן שיודע לעבוד בעומק רב.
- דיוק )Accuracy )- מכיוון שהתחום עבודה הוא קטן, הדיוק והרזולוציה חשובים לזיהוי נכון של העומק, כלומר על החיישן להיות בעל דיוק ורזולוציה גבוהה ככל הניתן. בחיישנים טובים ניתן להגיע לדיוק של מ"מ בודדים.
- המרה מהירה - מכיוון שמדובר על חיי אדם, כל שניה חשובה. מהירות הזיהוי של ילד שטובע היא הכרחית. לכן קיימת דרישה שהחיישן ידע להמיר במהירות את מתח היציאה האנלוגי הלא מקוזז מחיישן הלחץ הפיאזו-התנגדותי לערך דיגיטלי.
- חיישן אבסולוטי )Absolute )- חיישנים מסוג זה בעלי מקדמים פנימיים מכוילים במפעל, כלומר ניתן להשתמש בהם ללא חיישן נוסף מחוץ למים לקבל נתוני ייחוס.
- תקשורת מהירה ונוחה לשימוש שמתאימה למיקרו בקר כגון הארדואינו פרו מיני.

לאחר בדיקה מעמיקה ברחבי האינטרנט נמצא כי קיימת משפחת חיישנים בשם 5803MS 6TE שעונה על צרכי הפרויקט. ההבדל בין החיישנים במשפחה הוא הטווח לחץ
של חברת
שבוא ניתן להשתמש בחיישן. קיים חיישן עם טווח לחץ של עד bar 1 או עדbar 5 וכך הלאה.

בגלל בעיה של זמינות נרכש את החיישן שטווח העבודה שלו הוא עד bar .14 ולכן החיישן איתו מתבצעת העבודה הוא BA5803-14MS (https://www.sparkfun.com/products/12909)

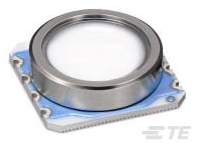
[picture p30: figure]

FEATURES:

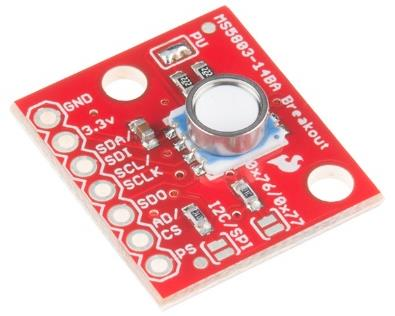
[picture p31: figure]

TE Connectivity ⁶ Tyco Electronics | לשעבר | ,(TEL:NYSE( TE Connectivity Ltd. | חברת | -
Integrated pressure sensor | 6.2 x 6.4 mm
Pressure range | 0 - 14 bar
Resolution | 1 / 0.6 / 0.4 / 0.3 / 0.2 mbar
Accuracy | ±20 mbar
ADC | 24 Bit
Output Interface | I 2C and SPI interface
Clock line | 32.768 kHz
Operating Temperature | -40 – 85 °C
Supply Voltage (V) | 1.8 – 3.6
Power consumption | Operating current < 1uA Standby current < 0.15uA
טבלה 4 - מאפייני החיישן מתוך דף המפרט | תמונה 12 - BA5803-14MS

21

מנוע זרם ישר )Motor DC)

הדרישה העיקרית מהמנוע בפרויקט היא שהמנוע יהיה בעל כוח זוויתי )מומנט - torque ) מספיק חזק בשביל לסובב את השסתום שמיועד לסגירת מעבר או לוויסות הזרימה של הגז.

כמו כן דרישה חשובה נוספת המשותפת לכל רכיבי המערכת היא הגודל הרכיב. לכן המנוע יהיה קטן בממדיו.

צריכת אנרגיה של המנוע פחות חשובה לנו מכיוון שהמנוע יפעל רק במקרה חירום. רק היה חשוב לוודא שהסוללה תוכל לתת לו את הזרם הדרוש להתנעה.

בעקבות דרישות אלה בחרו לעבוד עם מנוע זרם ישר )Motor DC )קטן בעל מערכת תמסורת פנימית של גלגלי שיניים לאחר שנבדקה אופציה נוספת )מנוע סרוו(. מנוע הסרוו שעמד בדרישות הגודל לא היה בעל כוח זוויתי מספיק לפתיחת השסתום.

מאפיינים:

בקר מנוע זרם ישר

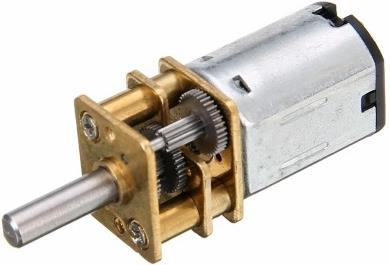
[picture p32: figure]

גם בבחירת רכיב זה הייתה דרישה של גודל רכיב קטן ככל האפשר. בנוסף הרכיב צריך להיות בעל צריכת אנרגיה נמוכה מאוד במצב שינה, כי במצב זה הוא יהיה כל הזמן, למעט מקרה טביעה.

לכן הרכיב שנבחר לצורך שליטה בפעולת המנוע הוא רכיב FNG6612TB של חברת .Toshiba

רכיב זה דוחף זרם לשני מנועים שיכול לספק זרם קבוע של עד A1.2 לכל ערוץ, או זרם רגעי של A.3.2 הוא כולל הגנות פנימיות מפני מתח נמוך, זרם גבוה או התחממות של הרכיב.

שתי כניסות 1IN ו2-IN משמשות לבחירת כיוון הסיבוב בלימה או עצירה של המנוע.

מהירות הסיבוב נשלטת ע"י אות PWM בתדר של עד KHz .100 אפשר לשלוט על כל ערוץ בנפרד. כדי שהרכיב יעבוד, צריך לעלות את כניסת ה-Standby ל1- לוגי.

מהירות סיבוב rpm 22
מתח עבודה V6
צריכת זרם ללא עומס mA 40
צריכת זרם עם עומס mA 350
זרם תקיעה mA 670
כוח סיבוב )מומנט( cm-kg 6.5 משקל 10 גרם
טבלה 5 - מאפייני המנוע מתוך דף המפרט תמונה 13 - V6 motor DC geared Mini

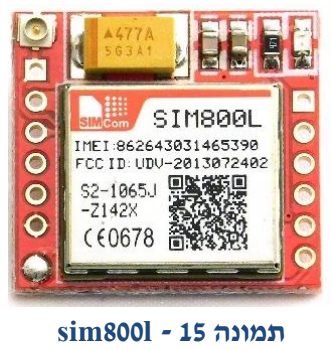
[picture p33: figure]
sim800l - 15; תמונה

22

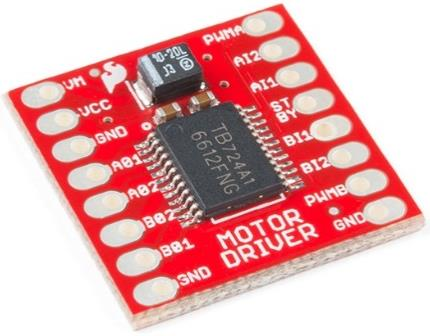
[picture p34: figure]

תמונה 14 - בקר מנוע DC FNG6612TB

מאפיינים:

מתאם תקשורת סלולרית )Module GSM GPRS)

הדרישה העיקרית מהרכיב, היא היכולת לשלוח הודעת חירום והודעה לבדיקת תקינות המערכת למרכז בקרה. תחום התדרים איתו עובד הרכיב צריך להתאים לתחום התדרים הנפוץ בישראל. אין צורך לקבל או לבצע שיחות בפרויקט זה.

כמו כן דרישה חשובה נוספת המשותפת לכל רכיבי המערכת היא הגודל. לכן הרכיב יהיה קטן בממדיו ולא יתפוס שטח גדול בתוך המארז האטום. בנוסף הרכיב צריך להיות בעל צריכת הספק נמוכה לשמירת הסוללה.

הרכיב העונה על צרכי הפרויקט ואיתו מתבצעת העבודה הוא L800SIM:

Features:

Quad-band 850/900/1800/1900MHz
Connect onto any global GSM network with any 2G SIM Make and receive voice calls using a headset
Send and receive SMS messages
Send and receive GPRS data (TCP/IP, HTTP, etc.)
Lead out buzzer and vibrational motor control port AT command interface with "auto baud" detection Supply Voltage: 3.3 - 4 V
Current Consumption:
Stand-by: 15 mA
Sleep mode: 1 mA
SMS send: 60 mA

מתח עבודה V2.7 - 5.5
מתח כניסה עד V15
זרם רגעי מקסימלי A3.2
צריכה זרם בעבודה mA 40
צריכה זרם בשינה μA1
תקשורת PWM
אורך 20.3 מ"מ
רוחב 20.3 מ"מ
טבלה 6 - מאפייני בקר המנוע מתוך דף המפרט

טבלה 7 - מאפייני רכיב ה - gsm מתוך דף המפרט

23

)DC/DC Boost Converter + Charger( | סוללות | מטען | + | מתח | ממיר

בשוק קיימים מעגלים שיודעים להמיר מתח מ- V3.7( מתח הסוללה( למתח עבודה של V6 ובנוסף לשמש בתור מטען סוללות. היתרון של מעגלים אלה בפרויקט הוא כמובן החיסכון במקום. אין צורך ב - 2 מעגלים נפרדים להגברת המתח ולהטענת הסוללה.

הרכיב העונה על צרכי הפרויקט ואיתו מתבצעת העבודה הוא CVSA05DD, ברכיב זה יש את בקר טעינה IC 4056TP וממיר מתח.

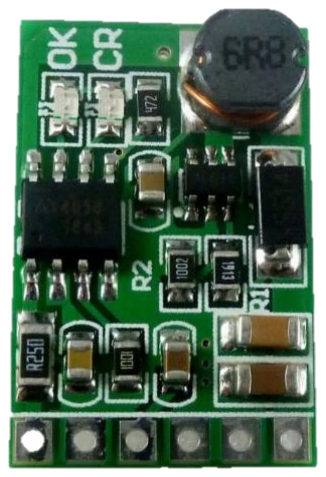
[picture p35: figure]

מקור מתח –סוללת ליתיום-פולימר )LiPo - polymer ion Lithium)

הסוללה היא מתקן לייצור חשמל בזרם ישר. הסוללה מורכבת מ"תא חשמלי" אחד או יותר. ה"תא החשמלי" הנפוץ כיום הוא תא אלקטרוכימי שבו החשמל מופק כתוצאה מתהליך כימי. "סוללה נטענת" משלבת למעשה תא אלקטרוכימי להפקת חשמל, ותא אלקטרוליטי ל"השבת" אנרגיה לסוללה באמצעות שינויים כימיים, לצורך המשך הפקת החשמל.

ישנם סוגים שונים של סוללות, אך בפרויקט זה העבודה מתבצעת עם סוללת ליתיום-פולימר )LiPo), מכיוון שהן סוללות קטנות ודקות במיוחד המיועדות למכשירים חשמליים קטנים. הן שכיחות בעיקר במכשירים אלקטרונים ניידים, הודות לצפיפות האנרגיה הגבוהה שלהן, מספר מחזורי פריקה/טעינה גבוה ואיבוד נמוך של הקיבול במהלך המחזורים.

מחישוב משוער של צריכת הזרם של כל רכיבי המערכת, התקבל כי יש לעשות שימוש בסוללה של לפחות mAh1200 על מנת להפעיל את כל המערכת לתקופה של שבוע במצב שינה.

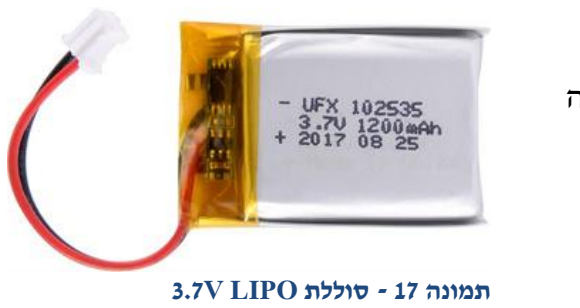
[picture p36: figure]
תמונה 17 - סוללת LIPO V3.7

כמו כן סוללה בגודל כזה היא מספיק קטנה בשביל להיכנס למארז האטום למים.

Charge voltage | DC 4.5V-8V
Charging current | 0-1A
(Boost in) Discharge current | 0-2A
(Boost in) Discharge quiescent current | 450μA
(Boost out) Output current | 0-1A (6V)
טבלה 8 - מאפייני רכיב ה ממיר מתח + מטען סוללות - מתוך דף המפרט

DC/DC Boost Converter + Charger - 16 תמונה

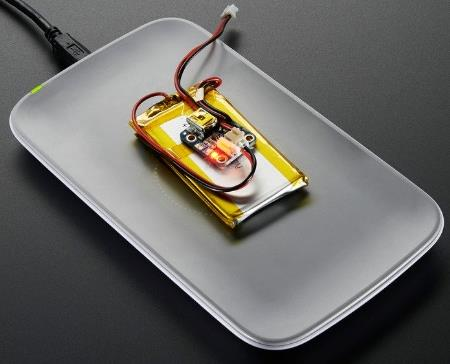
[picture p37: figure]

24

רכיב לטעינה אלחוטית )Module Receiver Wireless)

המערכת החשמלית יהיו בתוך מארז עמיד למים )67IP )שיאפשר כניסה למים ללא חשש של הריסת המכשיר. כדי למנוע פתיחה וסגירה של המארז כל פעם בשביל להטעין את הסוללה, תתווסף למערכת אופציה לטעינה אלחוטית.

להוספת אופציה זאת נעשה שימוש במקלט טעינה אלחוטית אשר כולל סליל נחושת ובקר טעינה.

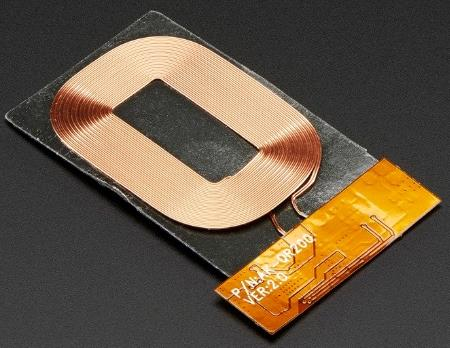
[picture p38: figure]

תמונה 18 - טעינה אלחוטית

25

.3.2.4 כניסות / יציאות במערכת החשמלית

קלטיים במערכת החשמלית:

- קלט רכיב הזיהוי של מגע עם מים: אות מתח אנלוגי.
- קלט חיישן העומק / לחץ: אות מתח אנלוגי, יקבל מתח מהמיקרו בקר.
- קלט מתאם תקשורת סלולרית: GSM, יקבל מתח ישירות מהסוללה.
- קלט מנוע DC: יקבל מתח מהבקר מנוע.
- קלט ממיר מתח + מטען סוללות: אות מתח אנלוגי.
- קלט המיקרו בקר: אות אנלוגי מרכיב זיהוי המים ומלחצן הבדיקה. תקשורת טורית סינכרונית )C²I )מהחיישן עומק / לחץ.
תקשורת טורית אסינכרונית )UART )למתאם תקשורת
סלולרית.
יקבל מתח ישירות מהסוללה.

פלטים במערכת החשמלית:

- פלט רכיב הזיהוי של מגע עם מים: אות מתח אנלוגי שיועבר למיקרו בקר.
- פלט חיישן העומק / לחץ: תקשורת טורית סינכרונית )C²I )בין החיישן למיקרו בקר.
- פלט מתאם תקשורת סלולרית: תקשורת טורית אסינכרונית )UART) הודעת SMS למרכז בקרה.
- פלט מנוע DC: סיבוב ציר המנוע - פתיחת ווסט ה2-Co.
- פלט ממיר מתח + מטען סוללות: אות מתח אנלוגי מוגבר.
- פלט המיקרו בקר: אות מתח דיגיטלי לבקר מנוע. תקשורת טורית אסינכרונית )UART )למתאם תקשורת סלולרית.
תקשורת טורית סינכרונית )C²I )לחיישן עומק / לחץ.

.3.3 מבנה הקוד )אלגוריתם(

המערכת משלבת תוכנה שנכתבה כדי לבצע את המטרות והדרישות שהוגדרו. החלק התכנותי במערכת, יהיה בקוד שכתוב בשפת ++C בסביבת הפיתוח Software Arduino IDE הצרוב על מיקרו-בקר.
האלגוריתם - שרשרת של פעולות ופקודות אשר לפיהן יעבדו רכיבי המערכת החשמלית. בקוד זה יהיה עיבוד האותות מהחיישנים, זיהוי טביעה ושליחת הודעת חירום למרכז

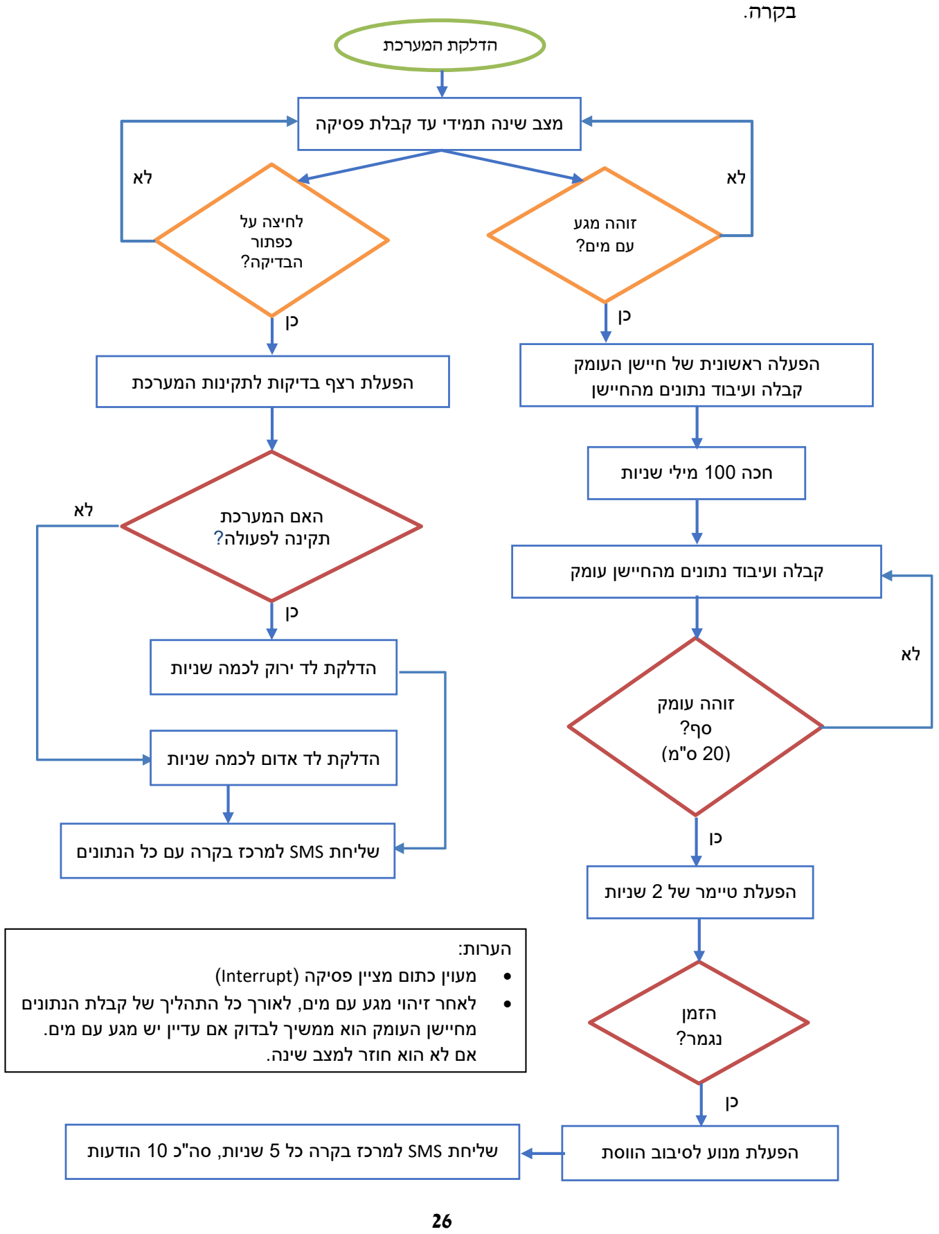
[picture p39: figure]
לחיצה על כפתור הבדיקה?; בקרה.; הדלקת המערכת; זוהה מגע עם מים?; הפעלה ראשונית של חיישן העומק קבלה ועיבוד נתונים מהחיישן; זוהה עומק סף? )20 ס"מ(; חכה 100 מילי שניות; הפעלת טיימר של 2 שניות; הזמן נגמר?; הפעלת מנוע לסיבוב הווסת; הפעלת רצף בדיקות לתקינות המערכת; הערות: • מעוין כתום מציין פסיקה )Interrupt); אם לא הוא חוזר למצב שינה.; האם המערכת תקינה לפעולה?; שליחת SMS למרכז בקרה עם כל הנתונים; הדלקת לד ירוק לכמה שניות; הדלקת לד אדום לכמה שניות; מצב שינה תמידי עד קבלת פסיקה; קבלה ועיבוד נתונים מהחיישן עומק

שליחת SMS למרכז בקרה כל 5 שניות, סה"כ 10 הודעות

- לאחר זיהוי מגע עם מים, לאורך כל התהליך של קבלת הנתונים מחיישן העומק הוא ממשיך לבדוק אם עדיין יש מגע עם מים.

27

.3.3.1 פירוט האלגוריתם

הקוד המלא נמצא בנספח מספר .1

האלגוריתם בנוי מ - 5 ספריות עזר:

- SoftwareSerial - מאפשר תקשורת טורית על כניסות דיגיטליות אחרות של הארדואינו, עבור רכיב L800SIM( ספריה מובנית(.
- Wire - תקשורת עם C
I, עבור חיישן הלחץ BA5803-14MS( ספריה | 2
מובנית(.
- LowPower - ספריית לניהול מצב השינה של המיקרו בקר.
- C2I_5803MS_SparkFun - מאפשר לדבר בקלות עם חיישן הלחץ .MS5803-14BA
- Battery - מאפשר פיקוח על צריכת הסוללה.

האלגוריתם בנוי מ - 4 פונקציות עיקריות, 2 פונקציות פסיקה ושאר הפונקציות משמשות כפונקציות עזר.

הפונקציות העיקריות הן:

- void setup()

פונקציה זו נקראת כאשר המיקרו בקר מתחיל להריץ את הקוד. אנו משתמשים בפונקציה זו לאתחל משתנים, מצבי כניסות / יציאות, להתחיל להשתמש בספריות, הכנסה למצב שינה וכדומה. בנוסף פונקציה זו עושה בדיקת תקינות לרכיבי המערכת באופן אוטומטי. לאחר הבדיקה שולחת הודעה עם פרטי הבדיקה למרכז בקרה.
קלט: אין
פלט: אין
- void loop()
הפונקציה עושה בדיוק את מה ששמה מרמז, לולאה אינסופית. היא מאפשרת / משביתה פסיקות, מפעילה מצב השינה, מפעילה מנגנוני זיהוי טביעה ומפעילה רצף בדיקת המערכת. קלט: אין
פלט: אין

28

- void In_water()
פונקציה זו נקראת על ידי ()loop לאחר סיום פונקציית הפסיקה המתאימה. מודד לחץ ראשוני ולאחר פרק זמן מסוים מודד שוב ואז שולח את הנתונים לפונקציה ()depth_Check לחישוב הפרש הגובה. אם הפרש הגובה הוא מתחת לסף )לזמן

מוגדר מראש(, הפונקציה ()detected_Drowning מופעלת. אחרת, הפונקציה

מסתיימת וחוזרת לפונקציית הלולאה ()loop. קלט: אין
פלט: אין
- void Check_device()
פונקציה זו נקראת על ידי ()loop לאחר סיום פונקציית הפסיקה המתאימה )זוהתה לחיצה על כפתור הבדיקה(. בודקת את כל רכיבי המערכת ולאחר מכן שולחת הודעת SMS מתאימה למרכז בקרה. אם כל הרכיבים תקינים ואחוז הסוללה הוא בטווח המתאים נדלק לד ירוק, אחרת אדום. קלט: אין
פלט: אין

פונקציות הפסיקה הן:

- void Water_activated_switch()
פונקציה זו נקראת כאשר יש עליה בפין מספר 2 )פונקציית פסיקה(. היא מעבירה את הדגל InWater לנכון, במטרה לסמן שהמערכת מזהה מגע עם מים.
קלט: אין
פלט: אין
- void Button_activated_switch()
פונקציה זו נקראת כאשר יש ירידה בפין מספר 3 )פונקציית פסיקה(. היא מעבירה את הדגל dev_Check לנכון, במטרה לסמן שהמערכת מבצעת בדיקה לרכיבי המערכת.
קלט: אין
פלט: אין

29

פונקציות העזר הן:

- double Check_depth(double pressure_baseline())
פונקציה זו נקראת על ידי ()water_In כאשר נדרש לחשב את דלתא הגובה. מקבלת מדידת לחץ ראשונית ולאחר פרק זמן מסוים, מודדת שוב ומחשבת את ההפרש בגובה.

קלט: baselin_pressure( Po )בתור רפרנס.

altitude_delta :פלט

- void Drowning_detected() פונקציה זו נקראת על ידי ()water_In כאשר זוהה מקרה טביעה. הפונקציה מתזמנת שתי פונקציות שונות למניעת טביעה. הפונקציה הראשונה היא של פתיחת השסתום לשחרור ה - 2Co. פונקציה שנייה לשליחת הודעת חירום למרכז בקרה. קלט: אין
פלט: אין
- void Toggle_valve()
פונקציה זו נקראת על ידי ()detected_Drowning כאשר זוהה מקרה טביעה. אם הדגל שגוי )השסתום סגור( הפעל את בקר המנוע והפעל את המנוע לפתיחת השסתום ולהיפך.
קלט: אין
פלט: אין
- void Sending_sms(String message) פונקציה זו נקראת על ידי ()detected_Drowning כאשר זוהה מקרה טביעה

או על ידי ()device_Check כאשר זוהתה לחיצה על כפתור.

היא מעירה את ה - L800SIM ושולחת הודעת SMS( לפי המחרוזת שהתקבלה ולפי המצב במצב בו אנו נמצאים( למרכז בקרה. לאחר שליחת הודעות, חזור לישון. קלט: message מחרוזת
פלט: אין

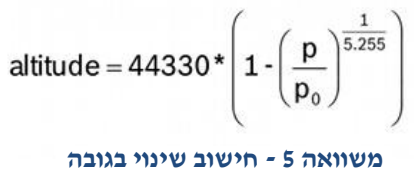
[picture p40: figure]
משוואה 5 - חישוב שינוי בגובה

30

- void Check_device()
פונקציה זו נקראת על ידי )(loop כאשר זוהתה מקרה של לחיצה על כפתור בדיקת

הרכיבים. בודק את כל רכיבי המערכת ואז שולח SMS מתאים למרכז בקרה. אם כל הרכיבים עובדים ותקינים, נורת לד ירוקה נדלקת אחרת נורד לד אדומה נדלקת.
קלט: אין
פלט: אין
- String readSerial()
הפונקציה מחזירה את הפלט של רכיב ה - GSM במטרה לעקוב אחרי תוצאות הפקודות שנשלחו לרכיב.
קלט: אין
פלט: הפלט של רכיב ה - GSM

.3.4 אתגרים במימוש

במהלך העבודה על הפרויקט נתקלנו במספר אתגרים ובעיות שדרשו התייחסות במיוחדת על מנת להגיע למצב בו המערכת עובדת באופן מלא ומדויק. להלן האתגרים איתם התמודדנו ודרכי הפתרון:

1( זיהוי מגע עם מים בצורה מדויקת ואמינה

על מנת שזיהוי מגע עם מים יהיה יעיל ומהיר נדרש למצוא פתרון ולשלב אותו במערכת. לאחר בדיקות וניסויים של כלל האופציות הוחלט להשתמש בשני פרובים לזיהוי מגע עם מים. כאשר המעגל נסגר )בעזרת מוליכות המים(, זה ייחשב כמגע עם מים.

2( קבלה ועיבוד הנתונים מחיישן הלחץ / עומק

כאשר חיישן הלחץ מעביר נתונים למיקרו בקר הוא עושה את זה בעזרת תקשורת 2 טורית C
I. בהתחלה נדרש ללמוד איך ליצור את הקשר הזה בין החיישן למיקרו בקר.
לאחר שהחיישן העביר נתונים, נדרש לנתח את המידע ולדעת להשתמש בו לטובת חישוב שינוי הגובה. לאחר קריאה מרובה וחיפוש באינטרנט נמצאה נוסחה שמאפשרת למצוא את השינוי בגובה בעזרת ההפרש בין שני מדידות לחץ. לחץ ראשוני )לחץ רפרנס( ולחץ נוסף.

31

3( הפעלת רכיב ה - L800SIM בצורה רציפה וללא ניתוקים מהרשת

רכיב ה - L800SIM הוא רכיב לתקשורת סלולרית המשתמש בתקנים GSM ו -

GPRS( דור 2 ו- 2.5 בהתאמה(. אחת הבעיות עם הרכיב הזה היא שכל הזמן הרכיב מאבד את הרשת הסלולרית. בנוסף לקח הרבה זמן עד שהוא מתחבר לרשת. לאחר בדיקות רבות של קודים שונים לשימוש עם הרכיב, החלפה של האנטנה לאנטנה יותר גדולה ואיכותית לא נמצאה הסיבה לבעיה. העבודה נעשתה המפרט הטכני של הרכיב וסופק לו המתח והזרם הדרושים בשבילו.

בסופו של דבר, לאחר בדיקה מקיפה, התגלה כי לרכיב פיק צריכת זרם של עד A2 בעת חיבור לרשת הסלולרית. הסוללה שחוברה למערכת התאימה למשימה, הבעיה שהחוטים שמחוברים לסוללה דקים מידי, בעלי התנגדות גדולה. ולכן במטרה לפתור את הבעיה החוטים הוחלפו ובסוף חוטי המתח בין הסוללה לרכיב קוצרו. כתוצאה מהשינויים הללו, הרכיב מתחבר לרשת בלי בעיה ועובד בצורה רציפה וללא ניתוקים מהרשת.

4( הפעלת רכיב ה - L800SIM בצורה חסכונית

רכיב ה - L800SIM הוא רכיב לתקשורת סלולרית קטן וקומפקטי לצרכי הפרויקט. הבעיה שהוא הרכיב הכי זולל אנרגיה שקיים במערכת. במצב רגיל, כאשר מחובר לרשת הוא צורך כ - mA.13 מכיוון שאחת הדרישות בפרויקט שהרכיבים יהיו קטנים כל הניתן במטרה שיכנסו למארז קטן, הסוללה תהיה קטנה, כלומר תהיה בעלת קיבול נמוך יחסית. ולכן נדרש דרך להוריד את צריכת האנרגיה של הרכיב.

לאחר בדיקות וניסויים של קודים שונים הצלחנו הוכנס את הרכיב למצב שינה, מה שהוריד את צריכת האנרגיה שלו ל - mA.1

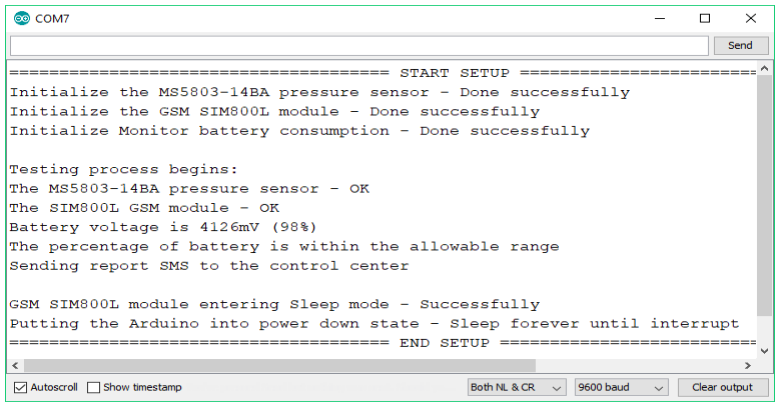
[picture p41: figure]

32

.4 תוצאות והדגמות

בתחילה מימוש הפרויקט נבדק כל רכיב בנפרד ונכתב לו קוד מתאים שיבצע את הדרוש ממנו לפי הדרישות שהוגדרו. לאחר שכל הרכיבים עבדו בנפרד כמצופה מהם, כל הקודים השונים חוברו לקוד אחד מרוכז שירוץ על המיקרו בקר.

כל רכיבי המערכת החשמלית חוברו על מטריצת בדיקות במטרה לבדוק את המערכת כולה. הקוד שנכתב נצרב על המיקרו בקר והתבצעה בדיקה של המערכת בכלל המצבים האפשריים.

לאחר הרצות ובדיקות של המערכת בשלמותה התקבלו תוצאות שתואמות לדרישות שהגדרנו.

.4.1 המערכת מבצעת בדיקת תקינות כללית לאחר הדלקתה

אחת הדרישות שהוגדרו היא לבצע בדיקת מערכת אוטומטית כללית לווידוי תקינות המערכת לאחר הלבשת השרשרת על הילד.

כאשר מדליקים את המערכת היא מבצעת סבב בדיקות לרכיבי המערכת. אם הכל תקין היא שולחת הודעה למרכז בקרה עם פרטי הבדיקות ומדליקה לד ירוקה המציין כי המערכת תקינה. אם יש בעיה היא מדווחת למרכז בקרה ומדליקה לד בצבע אדום המציין כי קיימת בעיה במערכת.

כפי שניתן לראות בתמונות הבאות המערכת מגיבה כמצופה ולפי הדרישה שהגדרנו.

תמונה 19 - המערכת מבצעת בדיקת תקינות כללית לאחר הדלקתה

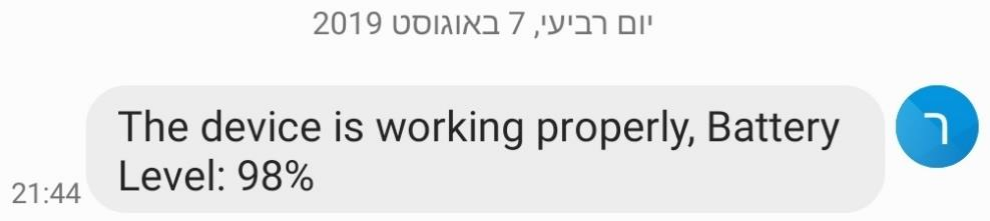
[picture p42: figure]
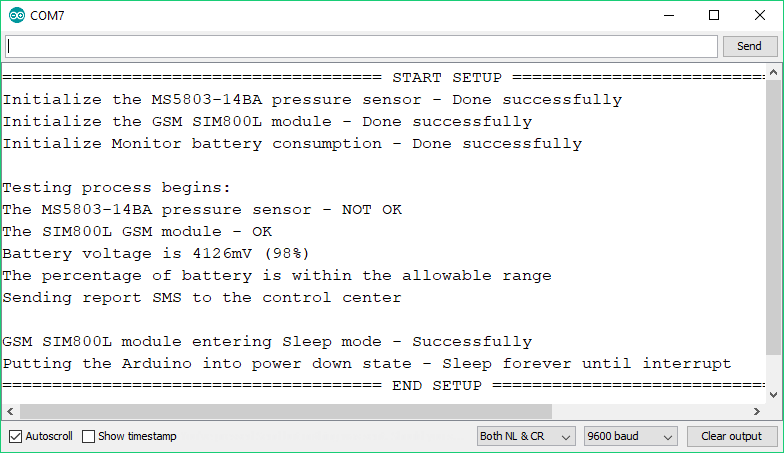
[picture p43: figure]

33

.4.2 הפעלת פסיקה לבדיקת תקינות המערכת לאחר לחיצה על הכפתור

אחת הדרישות שהוגדרו היא האפשרות לבצע בדיקת מערכת כללית יזומה לווידוי תקינות המערכת. לאחר הדלקת המערכת ובדיקת תקינות אוטומטית היא נכנסת למצב שינה.
אם קיים רצון לבצע בדיקת תקינות באופן יזום יש צורך ללחוץ על כפתור בדיקת התקינות. לחיצה על הכפתור מפעילה פסיקה שמעירה את המערכת.

לאחר לחיצה על הכפתור המערכת מבצעת סבב בדיקות לרכיבי המערכת. אם הכל תקין היא שולחת הודעה למרכז בקרה עם פרטי הבדיקות ומדליקה לד ירוקה המציין כי המערכת תקינה. אם יש בעיה היא מדווחת למרכז בקרה ומדליקה לד בצבע אדום המציין כי קיימת בעיה במערכת.

תמונה 21 - המערכת מבצעת בדיקת תקינות כללית לאחר הדלקתה

תמונה 20 - קבלת הודעת SMS למרכז בקרה שהכל תקין

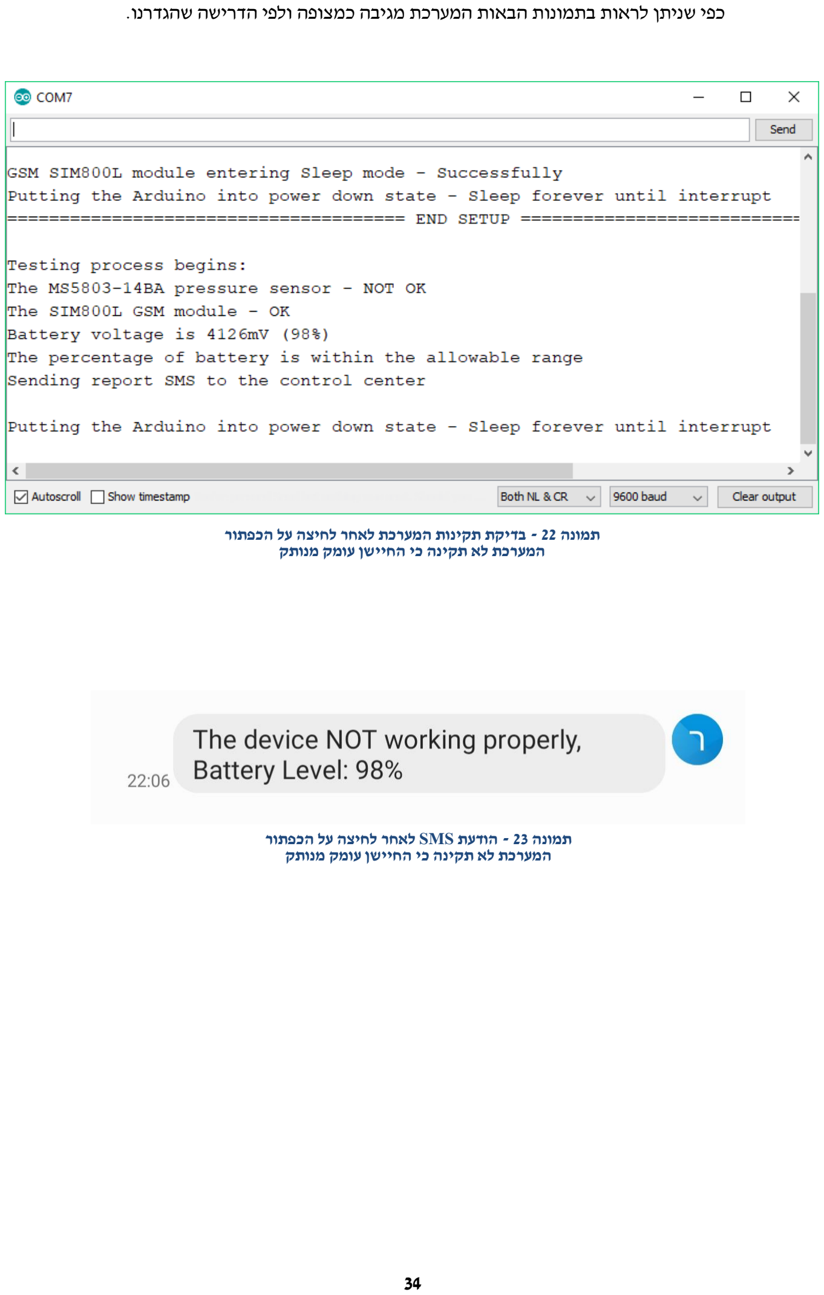
[picture p44: page 34]

34

כפי שניתן לראות בתמונות הבאות המערכת מגיבה כמצופה ולפי הדרישה שהגדרנו.

תמונה 22 - בדיקת תקינות המערכת לאחר לחיצה על הכפתור המערכת לא תקינה כי החיישן עומק מנותק

תמונה 23 - הודעת SMS לאחר לחיצה על הכפתור המערכת לא תקינה כי החיישן עומק מנותק


35

.4.3 זיהוי מגע עם מים

אחת הדרישות שהוגדרו היא לזהות מגע עם מים במטרה להעיר את המערכת משינה ולהתחיל למדוד את העומק בו נמצא התינוק / ילד. באופן זה המערכת נמצאת במצב שינה וצורכת פחות אנרגיה.

כאשר הפרובים מוכנסים למקור מים, המערכת מתעוררת, וכאשר הם מוצאים ממקור המים המערכת חוזרת למצב שינה.

כפי שניתן לראות בתמונה הבאה המערכת מגיבה כמצופה ולפי הדרישה שהגדרנו.

36

.4.4 קבלה ועיבוד נתונים מחיישן העומק

אחת הדרישות שהוגדרו היא לזהות את העומק בו נמצא התינוק / ילד כאשר הוא במקור מים. לשם כך המערכת משתמשת בחיישן לחץ למדידת הלחץ בכל רגע נתון. לאחר מדידה היא מחשבת את העומק בו התינוק / ילד נמצא באמצעות משוואה מספר .3

כפי שניתן לראות בתמונות הבאות המערכת מגיבה כמצופה ולפי הדרישה שהגדרנו.

תמונה 25 - קבלה ועיבוד נתונים מחיישן העומק


37

.4.5 זיהוי מצב טביעה

אחת הדרישות שהוגדרו היא זיהוי עומק סף: כתיבת אלגוריתם לזיהוי עומק שיוגדר מראש ובדיקה אם הערך שהתקבל אחרי ניתוח של תוצאות החיישנים על ידי הארדואינו חוצה את הסף.

בנוסף הפעלת טיימר לזמן מוגדר מראש שיבדוק אם הילד לא יוצא מהעומק סף במסגרת הזמן הזה.

כפי שניתן לראות בתמונות הבאות המערכת מגיבה כמצופה ולפי הדרישה שהגדרנו.

תמונה 26 - זיהוי מצב טביעה לאחר שנגמר הטיימר


38

.4.6 ניפוח בלוני ציפה כמנגנון ראשון להצלת התינוק / ילד

אחת הדרישות שהוגדרו היא שכאשר זוהתה טביעה, יופעל המנוע לסיבוב הווסת במטרה לשחרר את הגז מהמחסנית ובכך למלא את בלוני הציפה.

כפי שניתן לראות בתמונות הבאות המערכת מגיבה כמצופה ולפי הדרישה שהגדרנו.

תמונה 27 - ניפוח בלוני ציפה כמנגנון ראשון להצלת התינוק / ילד

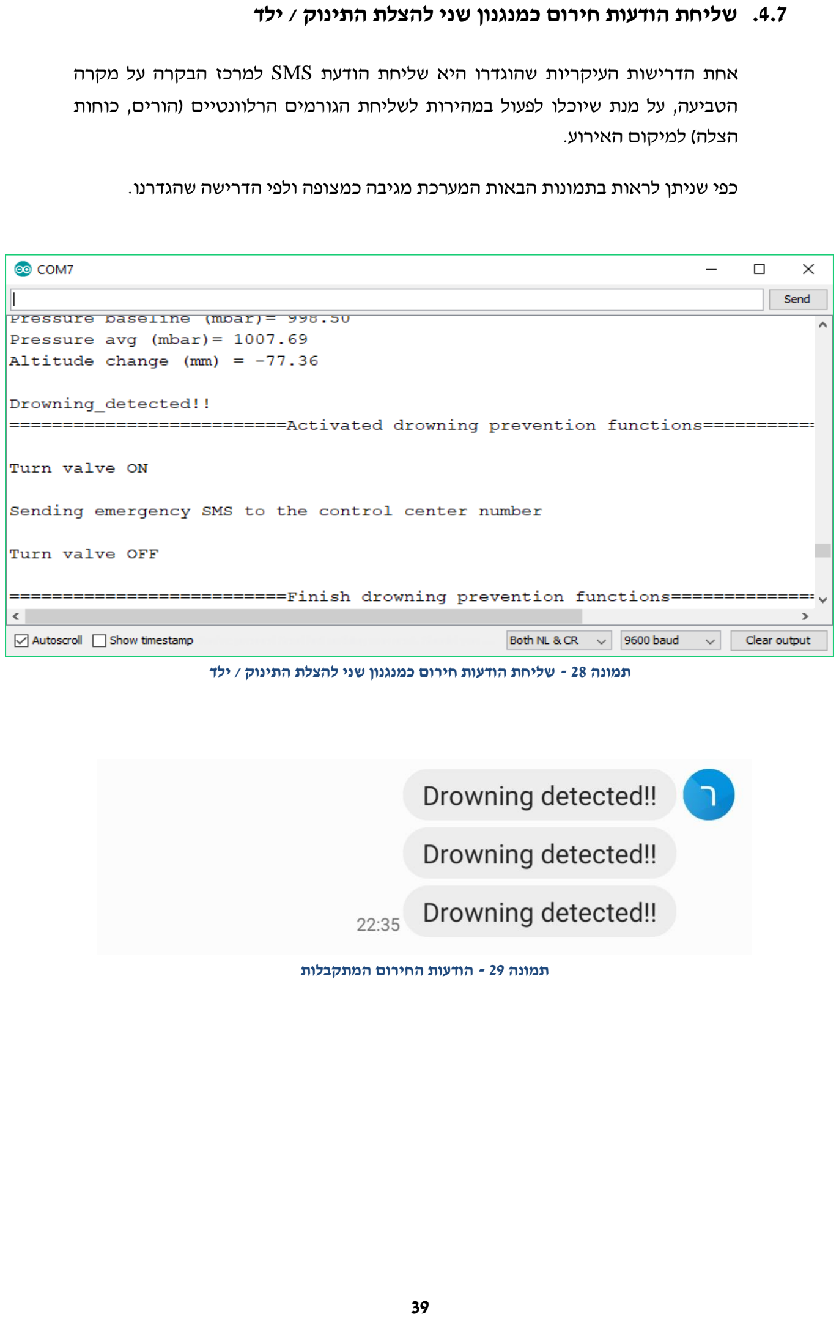
[picture p45: page 39]

39

.4.7 שליחת הודעות חירום כמנגנון שני להצלת התינוק / ילד

אחת הדרישות העיקריות שהוגדרו היא שליחת הודעת SMS למרכז הבקרה על מקרה הטביעה, על מנת שיוכלו לפעול במהירות לשליחת הגורמים הרלוונטיים )הורים, כוחות הצלה( למיקום האירוע.

כפי שניתן לראות בתמונות הבאות המערכת מגיבה כמצופה ולפי הדרישה שהגדרנו.

תמונה 28 - שליחת הודעות חירום כמנגנון שני להצלת התינוק / ילד

תמונה 29 - הודעות החירום המתקבלות

40

.5 מסקנות והמלצות

כפי שצוין בפרק ההקדמה מטרת הפרויקט היא לפתח מערכת המשלבת חומרה ותוכנה שתדע לזהות מקרה טביעה בקרב ילדים ותיתן מענה מהיר ונכון לצורך הצלת חיי הילד בעת טביעה.

המערכת החשמלית שתוכננה ונבנתה במהלך הפרויקט, עונה על הדרישות שהוגדרו. במקרה של תקציב יותר גדול ניתן היה להגיע למוצר מוגמר כמו שתוכנן. המוצר הסופי, כמו שניתן לראות בסעיף 3.2.1 )מבנה חיצוני( המוצר הסופי יהיה בנויה בצורת שרשרת אשר יולבש על צוואר הילד. משני צידי השרשרת יהיו בלוני ציפה מקופלים לתוך השרשרת עצמה. לשרשרת יחובר מארז עמיד למים ובתוכה תהיה מערכת חשמלית.

.5.1 תוצאות והישגים

1( המערכת החשמלית שתוכננה ונבנתה במהלך הפרויקט, עונה על הדרישות שהוגדרו. 2( הקוד שנכתב עומד בדרישות שהוגדרו. 3( הקוד של המערכת מתועד היטב, על מנת לאפשר עדכונים ושיפורים עתידיים. 4( על אף כל האתגרים שתוארו בפרק 3 המערכת עומדת בכל הדרישות שעלו בשלב התחלתי של הפרויקט.

.5.2 המלצות להמשך

- בניית אב-טיפוס של המוצר הסופי ובדיקתו בבריכה ובים.
- תכנון מעגל מודפס שיכיל את כל רכיבי המערכת החשמלית ובכך ליצור מוצר קטן יותר.
- הדפסה בתלת מימד את המארז למערכת החשמלית, לקבלת מראה אלגנטי יותר ולקבלת מערכת נוחה יותר לשימוש על צוואר הילד.
- הכנסת רכיב נוסף למערכת - רמקול קטן שיצפצף במקרה של טביעה, לקבל תשומת הלב של הסובבים.

41

.6 ביבליוגרפיה

.1 ספר "מדריך ארדואינו למתחילים חלק א" URL: https://hackstore.co.il/books/arduino-for-beginners-1/.2 ספר "מדריך ארדואינו למתחילים חלק ב" URL: https://hackstore.co.il/books/arduino-for-beginners-2/ Arduino Pro Mini 328 - 3.3V/8MHz .3 URL: https://www.sparkfun.com/products/11114
ATmega328P datasheet .4
URL: https://www.sparkfun.com/datasheets/Components/SMD/ATMega328.pdf Pressure Sensor Breakout - MS5803-14BA .5 URL: https://www.sparkfun.com/products/12909
MS5803-14BA datasheet .6
URL: https://cdn.sparkfun.com/datasheets/Sensors/Weather/ms5803_14ba.pdf LiPo Charger/Booster .7
URL: https://www.sparkfun.com/products/14411
GPRS GSM Module (SIM800L) .8 URL: https://filipeflop.com/files/download/Datasheet_SIM800L.pdf (https://img.filipeflop.com/files/download/Datasheet_SIM800L.pdf) Micro Metal Gearmotors .9
URL: https://www.pololu.com/pololu-micro-metal-gearmotors (https://www.pololu.com/file/0J1487/pololu-micro-metal-gearmotors.pdf)

Motor Driver - TB6612FNG .10 URL: http://www.sparkfun.com/datasheets/Robotics/TB6612FNG

Lithium Ion Polymer battery .11 URL: https://learn.adafruit.com/li-ion-and-lipoly-batteries 12-gram CO2 cartridge .12
URL: https://www.spudfiles.com/wiki/12_gram_CO2_cartridge (https://www.spudfiles.com/spud_wiki/index.php?title=12_gram_CO2_cartridge)
.13 משרד הבריאות - בטיחות ילדים במים ומניעת טביעה URL: https://www.health.gov.il/KidsAndMatures/safety/DrownPrevent (https://www.health.gov.il/Subjects/KidsAndMatures/safety/Pages/DrownPrevent.aspx) .14 היפגעות ילדים בישראל: דו"ח 'בטרם' לאומה 2017 URL: http://www.beterem.org/Beterem_ChildInjury2017.pdf (http://www.beterem.org/download/files/Beterem_ChildInjury2017.pdf)
.15 מידע על סוגי בדים לבלוני ציפה URL: https://www.diypackraft.com/packraft-details/fabrics (https://www.diypackraft.com/construction/packraft-details/fabrics/) .16 רמת אטימות IP - מה זה רמת IP לציוד חשמלי, באתר המוסד לבטיחות ולגיהות URL: http://oldsite.osh.org.il/d_1527_ip.pdf (http://oldsite.osh.org.il/uploadfiles/d_1527_ip.pdf)
Human Body Density and Fat .17 URL: https://doi.org/10.1093/ajcn/20.4.305
The American Journal of Clinical Nutrition, Volume 20, Issue 4, April 1967, Pages 305–310 Published: 01 April 1967
.18 מדריך למורה - לביצוע עבודות גמר : פרויקט במגמת הנדסת אלקטרוניקה ומחשבים URL: https://school.kotar.cet.ac.il/KotarApp/BookID=98064720#51
מקום ההוצאה: תל אביב, הוצאה: מטח: המרכז לטכנולוגיה חינוכית. שנת ההוצאה: תשע"ב - 2012

.19 יסודות הפיזיקה א : מכניקה, אלקטרוסטיטקה, זרם ישר - יחידות 1-2 URL: https://kotar.cet.ac.il/nBookID=93001430 (https://kotar.cet.ac.il/KotarApp/Index/Book.aspx?nBookID=93001430)
מקום ההוצאה: רעננה, הוצאה: האוניברסיטה הפתוחה. שנת ההוצאה: תשנ"ט - 1999

42

ABSTRACT .7

Injuries and deaths from drowning, especially of infants and children, have become a sad routine in Israel and around the world. Drowning is the second cause of mortality in children. Imprints are usually caused by the absence of supervision, even by a few seconds. It can happen at sea or at the pool.

Because of this important problem, it was decided to develop a system that integrates hardware and software that will recognize a drowning case in children and provide a quick and correct response to save the child's life while drowning. The system is for children aged 0-8 who cannot swim and should not enter the water without adult supervision.

The system is responsible for identifying the drowning and operating the various mechanisms to save the child if necessary. The electrical system includes a microcontroller, motor, power source, GSM component and various sensors that will monitor the depth of the child in the water. When the child is at a certain depth for a predetermined amount of time, the electrical system will operate different mechanisms to save the child.

A first mechanism and the main requirement of the system is the ability to raise the child's head above the water and keep it in this position. Responding to this requirement avoids contact with the airways leading to suffocation. A second mechanism is to send an emergency message (SMS) to a control center, where the event will operate, sending an SMS message back to the parents. This mechanism meets the requirement for parental attention. There is also a button to check the system's integrity. In response to a click, you will send an SMS with a detailed health report.

At the implementation stage, all electrical components were connected to one system and a code was written to Arduino that fulfills the defined requirements. The system detects contact with water using 2 probes when they are inserted into a water source, after which the system turns on and starts to process data from the pressure / depth sensor. With the sensor you can measure a pressure of exactly 0.01% and calculate the depth difference where the sensor is located. The system performs pressure measurements, and alerts about any drowning condition as soon as the depth exceeds 10 cm. After crossing the threshold, it activates a 2-second timer.

The voltage required to run the motor is 6V and therefore a voltage converter is used, which increases the voltage of the LiPo battery to the required voltage. After inflating the buoyancy balloons, the system sends an emergency message to a control center. The SMS is sent via the cellular communication component. In addition to the initiated integrity check by pressing a button, the system performs an automatic integrity check for the system components when it is turned on. After an initiated or automatic integrity check, the data is sent to a control center and the LED is lit in the color corresponding to the test result.

After many tests and experiments it can be said that the system fulfills the requirements defined in the design phase. The system is capable of recognizing drowning at a very high accuracy percentage. The total system consumption is about 4.5 mA in sleep mode, and about 15mA when the system is in contact with water. Because the final product has a battery size limit, it was decided that the system must be turned off until it is mounted on the child's neck. It will automatically turn on as soon as the chain bracket is locked. In the case of a larger budget, a finished product could be reached that could be dressed for the child.

43

.8 נספחים

.8.1 נספח :1 קוד המערכת

הקוד הבא הוא קוד בדיקה )Debugging )המכיל הרבה print.Serial במטרה לבדוק את הקוד ובנוסף להצגה בשלב ההגנה.

// Version 0.9 - Debugging

// Include Libraries :
//-----------------------------------------------------------------------//
#include <SoftwareSerial.h> | // Allow serial communication on other

digital pins of the Arduino(built-in librarie) - for SIM800L
#include <Wire.h> | // Communicate with I2C (built-in

librarie) - for MS5803-14BA pressure sensor
#include <LowPower.h> | // Power management library

(https://github.com/rocketscream/Low-Power)
#include <SparkFun_MS5803_I2C.h> // Allows easily talk to the MS5803-14BA pressure sensor (http://librarymanager/All#SparkFun_MS5803-14BA)

#include <Battery.h> | // Allows monitor battery consumption

(https://github.com/rlogiacco/BatterySense)

SoftwareSerial SIM800L_Serial(11, 10); // TX and RX pins (respectively) to communicate with SIM800L module
MS5803 pressure_sensor(ADDRESS_HIGH); | // Available addresses (selected by
jumper on board) - ADDRESS_HIGH = 0x76 (default) OR ADDRESS_LOW | = 0x77
Battery batt = Battery(3000, 4200, A0); // minVoltage, maxVoltage and sensePin
//-----------------------------------------------------------------------//

// Define Pins :
//-----------------------------------------------------------------------// #define InWater_Prob 2 // The pin number for the Prob (Only pin 2,3 USABLE FOR INTERRUPTS)
#define Button 3 | // The pin number for the Push button (Only pin

2,3 USABLE FOR INTERRUPTS)
#define RedledPin 8 | // The pin number for the Red LED

#define GreenledPin 9 | // The pin number for the Green LED

// Pinout for TB6612FNG
#define PWMA 6 | // PWM input that controls the speed

#define AIN1 5 | // One of the two inputs that determines the direction.

#define STBY 7 | // Allows the H-bridges to work when high

#define AIN2 4 | // One of the two inputs that determines the direction.

//-----------------------------------------------------------------------//

// Global Variables :
//-----------------------------------------------------------------------//
volatile boolean InWater = false; | // Flag for symbolizes the contact
with water (volatile because associated with interrupt)
volatile boolean Check_dev = false; | // Flag that indicates test status
or not (volatile because associated with interrupt)
boolean Arduino_state = false; | // Flag for the Arduino status
(stand-by = true, sleep = false)
boolean Valve_state = false; | // Flag for the valve status (open
= true, close = false)
boolean Gsm_sleepMode = false; | // Flag for the SIM800L status
(stand-by = false, sleep = true) //-----------------------------------------------------------------------//

44

// Function Declaration :
//-----------------------------------------------------------------------// void Water_activated_switch();
void Button_activated_switch();
void In_water();
double Check_depth(double pressure_baseline); void Drowning_detected();
void Toggle_valve();
void Sending_sms(String message);
void Check_device();
//-----------------------------------------------------------------------//

/* --- setup() ------------------------------------------------------------This function is called when a sketch starts. We use it to initialize variables, pin modes, start using libraries, etc.
The function will only run once, after each powerup or reset of the Arduino board.
Input: None
Output: None
*/
void setup() {
pinMode(InWater_Prob, INPUT); | // Initialize the Prob pin as an input
| for water contact
pinMode(Button, INPUT_PULLUP); | // Initialize the button pin as an
| input with pull up resistor

// PinMode for common Anode RG
pinMode(RedledPin, OUTPUT); | // initialize the Red LED pin as an
| output
pinMode(GreenledPin, OUTPUT); | // initialize the Green LED pin as an
| output
digitalWrite(RedledPin, 255); | // set initial LED state
digitalWrite(GreenledPin, 255); | // set initial LED state

// PinMode for TB6612FNG
pinMode(STBY, OUTPUT); | // PWM input that controls the speed
pinMode(AIN1, OUTPUT); | // One of the two inputs that
| determines the direction
pinMode(AIN2, OUTPUT); | // Allows the H-bridges to work when
| high
pinMode(PWMA, OUTPUT); | // One of the two inputs that
| determines the direction
analogReference(INTERNAL); | // Configures the reference voltage
| used for analog input volts

// initialize serial communication at 9600 bits per second: Serial.begin(9600);

Serial.println(F("============= START SETUP ========================"));

// Start I2C object for the MS5803-14BA pressure sensor
Wire.begin();

Serial.print("Initialize the MS5803-14BA pressure sensor - ");
pressure_sensor.reset(); | // Reset device I2C
if (!pressure_sensor.begin()) { | // Initialize library for subsequent
| pressure measurements
Serial.println("Done successfully");
}
else {

45

Serial.println("Unsuccessful");
}

Serial.print("Initialize the GSM SIM800L module - ");
SIM800L_Serial.begin(9600); | // Initialize Serial Monitor for the
SIM800L
delay(50);

SIM800L_Serial.println("AT");
if ((readSerial().indexOf("OK")) != -1 ) { Serial.println("Done successfully");
}
else {
Serial.println("Unsuccessful");
}

Serial.println("Initialize Monitor battery consumption - Done successfully\n");
batt.begin(1100, 5.9651, &sigmoidal); | // Initialize monitor battery
consumption
Check_dev = true; | // Indicates that test mode enable.
Check_device();
Check_dev = false; | // After finish the Check_device, the flag
returns to its initial value

Serial.print("\nGSM SIM800L module entering Sleep mode - ");
SIM800L_Serial.println("AT+CSCLK=2"); | // Entering Sleep mode
if ((readSerial().indexOf("OK")) != -1 ) { Serial.println("Successfully");
Gsm_sleepMode = true; | // Indicates that the SIM800L
is in sleep mode
}
else {
Serial.println("Unsuccessful");
}

attachInterrupt(digitalPinToInterrupt(2), Water_activated_switch,
RISING); | // When pin 2 rising change, exit sleep mode and execute
Water_activated_switch function attachInterrupt(digitalPinToInterrupt(3), Button_activated_switch, FALLING); // At the push of a button, exit sleep mode and execute Button_activated_switch function

Serial.println(F("Putting the Arduino into power down state - Sleep forever until interrupt"));
Serial.println(F("=================END SETUP ======================\n")); delay (10000);
LowPower.powerDown(SLEEP_FOREVER, ADC_OFF, BOD_OFF); // Putting microcontroller into power down state - Sleep forever until interrupt
}
//-----------------------------------------------------------------------//

/* --- loop() -------------------------------------------------------------The function does precisely what its name suggests, and loops consecutively.
Enable / disable interrupt, enable sleep mode, and enable drowning detection mechanisms or Check device mechanisms.
Input: None
Output: None
*/
void loop() {

if (InWater) {

46

detachInterrupt(digitalPinToInterrupt(2)); // Remove interrupt to stop it from keep firing
detachInterrupt(digitalPinToInterrupt(3)); // Remove interrupt to stop it from keep firing
In_water(); | // Function is activated after exiting
sleep mode when water contact is detected
InWater = false; | // After leaving the water, the flag
returns to its initial value
Arduino_state = true; | // Indicates that the Arduino is in
stand-by mode
attachInterrupt(digitalPinToInterrupt(2), Water_activated_switch,
RISING); | // When pin 2 rising change, exit sleep mode and execute
Water_activated_switch function
delay(100);
}

if (Check_dev) {
detachInterrupt(digitalPinToInterrupt(3)); | // Remove interrupt to
stop it from keep firing
Check_device(); | // Function is activated after exiting
sleep mode when push of a button is detected
Check_dev = false; | // After finish the Check_device, the
flag returns to its initial value
Arduino_state = true; | // Indicates that the Arduino is in
stand-by mode
attachInterrupt(digitalPinToInterrupt(3), Button_activated_switch, FALLING); // At the push of a button, exit sleep mode and execute Button_activated_switch function
delay(100);
}

if (Arduino_state) {
Serial.println(F("\nPutting the Arduino into power down state - Sleep forever until interrupt"));
Arduino_state = false; // After finish the Check_device or In_water, the flag returns to its initial value (sleep)
delay (100);
LowPower.powerDown(SLEEP_FOREVER, ADC_OFF, BOD_OFF); // Putting microcontroller into power down state - Sleep forever until interrupt
}
}
//-----------------------------------------------------------------------//

/* --- Water_activated_switch ---------------------------------------------This function is called when pin 2 rising change (interrupt function). Switches the flag to water contact mode.
Input: None
Output: None
*/
void Water_activated_switch() {
InWater = true; | // Indicates that water
contact detected.
Check_dev = false; | // After finish the
Check_device, the flag returns to its initial value
}
//-----------------------------------------------------------------------//

/* --- Button_activated_switch() ------------------------------------------This function is called when pin 3 falling change (push of a button) (interrupt function).
Switches the flag to Check device mode.

*/

47

void Button_activated_switch() {
Check_dev = true; | // Indicates that push of a
button detected.
}
//-----------------------------------------------------------------------//

/* --- In_water() ---------------------------------------------------------This function is called by loop() after the interrupt function ended. Initial pressure gauge, after a certain amount of time, measures again and then sends the data
to the Check_depth() function to calculate the altitude difference. If the height difference is below the threshold (for a predefined time) then the Drowning_detected() function is activated.
Otherwise, the function ends and returns to the loop()function.
Input: None
Output: None
*/
void In_water() {

const float depth_threshold = -70.0; // The threshold depth from which a drowning is defined (Negative as we go down deep)

// Create variables to store results from the pressure sensor
double altitude_delta, pressure_baseline;

int timer_count = 0; // Used to measure time below the threshold

Serial.println("Contact with water detected - SYSTEM ON\n"); Serial.println("Start measuring pressure:\n");

pressure_baseline = pressure_sensor.getPressure(ADC_4096); // Read initial pressure measurement in mbar for reference (Po)

while (digitalRead(2) == HIGH) | { | // As long as there is contact with
water, calculate altitude delta
altitude_delta = Check_depth(pressure_baseline);
while (altitude_delta <= depth_threshold && digitalRead(2) ==
HIGH) | { | // As long as below the depth threshold, turn on timer
if (timer_count >= 2000) { | // 8 * 250 msec = 2 sec = 2000
msec
Drowning_detected(); | // Identified a drowning case
break;
}
Serial.print("Time below the threshold (msec)= ");
delay(250);
timer_count = timer_count + 250; Serial.println(timer_count);
altitude_delta = Check_depth(pressure_baseline); }
timer_count = 0;
delay(500);
}
Serial.println("Contact with water NOT detected - SYSTEM OFF");
}
//-----------------------------------------------------------------------//

/* --- Check_depth() ------------------------------------------------------This function is called by In_water() when we need to calculate the altitude delta.
Initial pressure gauge, after a certain amount of time, measures again and calculate the altitude difference.
Input: pressure_baseline (Po) for reference.
Output: altitude_delta.
*/
double Check_depth(double pressure_baseline) {

48

// Create variables to store results from the pressure sensor double pressure_abs, pressure_avg = 0.0, altitude_delta = 0.0;

// Perform a number of pressure measurements
// and average calculation for more accurate pressure
for (int i = 0; i < 10; i++)
{
// Read pressure from the sensor in mbar. pressure_abs = pressure_sensor.getPressure(ADC_4096); delay(100); // 100 msec delay
pressure_avg = pressure_avg + pressure_abs;
}
pressure_avg = pressure_avg / 10.0;

Serial.print("Pressure baseline (mbar)= "); Serial.println(pressure_baseline); Serial.print("Pressure avg (mbar)= "); Serial.println(pressure_avg);

/* Taking our baseline pressure at the beginning we can find an approximate
change in altitude based on the differences in pressure.
Given a pressure measurement P (mbar) and the pressure at a baseline P0 (mbar),
return altitude (millimeters) above baseline.*/

altitude_delta = (44330.0 * (1 - pow(pressure_avg / pressure_baseline, 1 / 5.255)));
Serial.print("Altitude change (mm) = "); Serial.println(altitude_delta);
Serial.println("");
return altitude_delta;
}
//-----------------------------------------------------------------------//

/* --- Drowning_detected() ------------------------------------------------This function is called by In_water() when we have identified a drowning case.
The function scheduling two different drowning prevention functions. The first function of opening the valve is to release the Co2.
Second function for sending an emergency message to a control center. Input: None
Output: None
*/
void Drowning_detected() {

Serial.println(F("Drowning_detected!!")); Serial.println(F("==========================Activated drowning prevention functions=========================="));
Toggle_valve(); | // Toggle the valve using
the DC motor
Sending_sms(String("Drowning detected!!")); // Sending an emergency message to a control center with the SIM800L
Toggle_valve(); | // Toggle the valve using
the DC motor
Serial.println(F("==========================Finish drowning prevention functions==========================\n"));
Serial.println(F("Continue to measuring pressure:\n"));

49

}
//-----------------------------------------------------------------------//

/* --- Toggle_valve() -----------------------------------------------------This function is called by Drowning_detected() when we have identified a drowning case.
If the flag is false (the valve is closed) start the engine controller and turn the engine to open the valve and vice versa
Input: None
Output: None
*/
void Toggle_valve() {
if (!Valve_state) { // If the valve close turn valve on Serial.println("\nTurn valve ON\n");

// Turn valve on
digitalWrite(STBY, HIGH);
digitalWrite(AIN1, LOW);
digitalWrite(AIN2, HIGH);
analogWrite(PWMA, 255);
delay(5000);
Valve_state = true; | // Indicates that valve in open

// Stop the motor
digitalWrite(AIN1, LOW);
digitalWrite(AIN2, LOW);
analogWrite(PWMA, 0);
delay(2000);
}
else {
Serial.println("\nTurn valve OFF\n");

// Turn valve off
digitalWrite(AIN1, HIGH);
digitalWrite(AIN2, LOW);
analogWrite(PWMA, 255);
delay(5000);
Valve_state = false; | // Indicates that valve in close

// Stop the motor
digitalWrite(STBY, LOW);
digitalWrite(AIN1, LOW);
digitalWrite(AIN2, LOW);
analogWrite(PWMA, 0);
}
}
//-----------------------------------------------------------------------//

/* --- Sending_sms() ------------------------------------------------------This function is called by Drowning_detected() when we have identified a drowning case
or by Check_device() when we have identified push of a button.
Wakes up the SIM800L and sends SMS (depending on the state we in) to a control center.
After sending messages, go back to sleep.
Input: String message
Output: None
*/
void Sending_sms(String message) {
const String number = "547280910"; | // Control Center Emergency Number

50

SIM800L_Serial.println("AT"); | // A dummy message to wake the
component
delay(150);
Gsm_sleepMode = false; | // Indicates that the SIM800L is in
stand-by mode

if (Valve_state) {
Serial.println("Sending emergency SMS to the control center number");

for (int i = 0; i < 3; i++) {
SIM800L_Serial.println("AT+CMGF=1"); | // Set the
Mode as Text Mode
delay(150);
SIM800L_Serial.println("AT+CMGS=\"+972" + number + "\""); // To send a message to a control center
delay(150);
SIM800L_Serial.print(message); | // Content
of the SMS message
delay(150);
SIM800L_Serial.write((byte)0x1A); | // End of
message character 0x1A : Equivalent to Ctrl+z
delay(50);
SIM800L_Serial.println();
delay(3000);
}
}
else if (Check_dev) {
Serial.println("Sending report SMS to the control center");
SIM800L_Serial.println("AT+CMGF=1"); | // Set the
Mode as Text Mode
delay(150);
SIM800L_Serial.println("AT+CMGS=\"+972" + number + "\""); // To send a message to a control center
delay(150);
SIM800L_Serial.print(message); | // Content
of the SMS message
delay(150);
SIM800L_Serial.write((byte)0x1A); | // End of message character 0x1A :
Equivalent to Ctrl+z
delay(50);
SIM800L_Serial.println();
delay(3000);
}

if (Gsm_sleepMode) {
Serial.print("GSM SIM800L module entering Sleep mode - ");
SIM800L_Serial.println("AT+CSCLK=2"); | // Entering Sleep mode
if ((readSerial().indexOf("OK")) != -1 ) { Serial.println("Successfully");
Gsm_sleepMode = true; | // Indicates that the SIM800L
is in sleep mode
}
else {
Serial.println("Unsuccessful"); }
}
}
//-----------------------------------------------------------------------//

/* --- Check_device() -----------------------------------------------------This function is called by loop() when we have identified a push buttan case.
Checks all system components and then sends an appropriate SMS to a control center.

51

If all components are correct, a green LED turns on, otherwise red. Input: None
Output: None
*/
void Check_device() {
Serial.println("Testing process begins:");
boolean fault = false; | // Flag that indicates if the device
is working properly (true = Not good)
boolean MS5803_state = false; | // Flag that indicates if the MS5803-
14BA pressure sensor is working properly (true = OK, false = NOT ok) String message = "";

int batt_volt = batt.voltage();
int batt_percent = batt.level();
float temperature_c = pressure_sensor.getTemperature(CELSIUS, ADC_256); // Temperature measurement to check the sensor pressure

if (temperature_c >= -20 && temperature_c <= 40) { Serial.println("The MS5803-14BA pressure sensor - OK"); MS5803_state = true;
}
else {
Serial.println("The MS5803-14BA pressure sensor - NOT OK"); MS5803_state = false;
fault = true;
}

SIM800L_Serial.println("AT"); // A dummy message to wake the component delay(200);

SIM800L_Serial.println("AT");
if ((readSerial().indexOf("OK")) != -1 ) { Serial.println("The SIM800L GSM module - OK"); }
else {
Serial.println("The SIM800L module - NOT OK"); fault = true;
}

Serial.print("Battery voltage is "); Serial.print(batt_volt);
Serial.print("mV (");
Serial.print(batt_percent); Serial.println("%)");

if (batt_volt >= 3300) {
Serial.println("The percentage of battery is within the allowable range");
}
else {
Serial.println("The percentage of battery is NOT within the allowable range");
fault = true;
}
if (fault) { | // One of the components is not
working or the battery is low
message = message + "The device NOT working properly, Battery Level: " + String(batt_percent) + "%";
digitalWrite(RedledPin, 0); | // Low battery -> Red led ON
digitalWrite(GreenledPin, 255); | // Low battery -> Green led OFF
}
else { | //All components work and the battery
is good

52

message = message + "The device is working properly, Battery Level: " + String(batt_percent) + "%";
digitalWrite(RedledPin, 255); | // OK battery -> Red Led OFF
digitalWrite(GreenledPin, 0); | // OK battery -> Green led ON
}

delay(5000);

Sending_sms(message); | // Sending report message to a
control center with the SIM800L
digitalWrite(RedledPin, 255); | // Turns off the Red LED
digitalWrite(GreenledPin, 255); | // Turns off the Green LED
}
//-------------------------------------------------------------------------

/* --- readSerial() -------------------------------------------------------The function returns the output of the SIM800L.
Input: None
Output: SIM800L_Serial.readString - The output of the SIM800L.
*/
String readSerial() {
int | _timeout = 0;
while | (!SIM800L_Serial.available() && _timeout < 1000 | ) | {
delay(13);
_timeout++;
}
if (SIM800L_Serial.available()) { return SIM800L_Serial.readString(); }
}

53

.8.2 נספח :2 בדיקות המערכת )STD)

.8.2.1 בדיקות הרכיבים החשמליים בנפרד

מס הבדיקה פעולה לביצוע תוצאה צפויה תוצאה הערות

| עובד כנדרש, קיימת תקשורת תקינה בין המחשב לבקר. הצריבות מתבצעות בהצלחה. | במסך ה monitor serial של IDE נראה שינויים בהתאם לקוד. | כתיבת קוד לבדיקת התקשורת. ניסיון צריבת למיקרו בקר בעזרת סביבת העבודה )IDE )של ארדואינו. | בדיקת תקשורת טורית בין המחשב למיקרו בקר )USB) | 1
ניתן להוריד עוד את צריכה, ע"י הסרת הלדים )0.2mA( | ACT - 5 mA PDS - 1 mA | בהתאם למפרט הטכני של המיקרו בקר. | מדידת צריכת הזרם של המיקרו בקר בשני מצבים: במצב רגיל )הכל מופעל( במצב שינה עמוק | בדיקת צריכת האנרגיה של המיקרו בקר | 2
| עובד כנדרש, התקבלה הודעת SMS עם התוכן המבוקש למספר שהוגדר. | קבלת ההודעה בטלפון. | כתיבת קוד וצריבתו במיקרו בקר לשליחת SMS לטלפון שלנו. | בדיקת תקשורת טורית סינכרונית )UART )בין המיקרו בקר לבקר תקשורת סלולארית | 3
| עובד כנדרש, קורא באופן תקין את העומק בו נמצא החיישן. | הצגת העומק בו נמצא החיישן במסך serial monitor -ה הקריאה תהיה תואמת לעומק בו נמצא החיישן. | כתיבת קוד וצריבתו במיקרו בקר למדידת העומק בו נמצא החיישן והצגתו במסך ה - monitor serial. | בדיקת תקשורת טורית סינכרונית בין המיקרו בקר לחיישן עומק | 4
| עובד כנדרש, המנוע מצליח לפתוח ולסגור את הווסת. | בהתאם למפרט הטכני של המנוע. | חיבור המנוע לווסת ולמקור מתח לבדיקת יכולתו המכאנית לסיבוב הווסת. | בדיקת התאמת פעילות המנוע למפרט הטכני שלו | 5
| No Load - 42 mA Load - 330 mA Stall - 670 mA | בהתאם למפרט הטכני של המנוע. | מדידת צריכת הזרם של המנוע בשני מצבים: עם עומס )הווסת מחובר( בלי עומס | בדיקת התאמת פעילות המנוע למפרט הטכני שלו | 6
| עובד כנדרש, קיימת הגנה על הסוללה. | בהתאם למפרט הטכני של ממיר המתח + מטען סוללה | בדיקת יכולת הרכיב להגן על הסוללה במצבים הבאים: Overcharge, Discharge and Short circuit | בדיקת ממיר המתח + מטען סוללה בהתאם למפרט הטכני שלו. | 7

54

מס הבדיקה פעולה לביצוע תוצאה צפויה תוצאה הערות

No Load - 462μA | בהתאם למפרט הטכני של ממיר המתח + מטען סוללה | בדיקת ממיר המתח וצריכת האנרגיה שלו | בדיקת ממיר המתח + מטען סוללה בהתאם למפרט הטכני שלו. | 8
עובד כנדרש, בהנחת הרכיב על המשטח טעינה הסוללה נטענת | מטען הסוללה יקבל את הזרם הדרוש להטענת הסוללה. מתחילה להיטען לפי הצפי. | לבדוק שרכיב הטעינה האלחוטית מספק מספיק זרם לטעינת הסוללה. | בדיקת טעינה אלחוטית כמקור מתח למטען הסוללה | 9
עובד כנדרש, אין בריחת גז | הווסת ינקב את המחסנית ולא יאפשר בריחת גז עד סיבוב הווסת. | חיבור הווסת למחסנית 2co ובדיקת דליפות. | בדיקת כשירותו המכאנית של הווסת | 10
עובד כנדרש, בעת הכנסת הפרופים למים, נדלק ה-LED | הרכיב יזהה מגע עם מים. | הכנסת הפרובים למים. צריבת הקוד המתאים למיקרו בקר | בדיקת יכולות הרכיב לזיהוי מגע עם מים | 11
המארז אטום למים | המארז עמיד למים כפי שמצוין במפרט שלו | הכנסת המארז למקור מים עם צמר גפן | בדיקת אטימות המים של המארז | 11

55

.8.2.2 בדיקות המערכת בשלמותה

מס הבדיקה פעולה לביצוע תוצאה צפויה תוצאה הערות

השינוי נובע מהוספת כמה רכיבים שלא נכללו בחישובים | קצת יותר גבוה מהמחושב Sleep - 4.5 mA | תואם את החישובים שבוצעו. | מדידת צריכת כלל המערכת במצב שינה | בדיקת צריכת כלל המערכת במצב שינה )מחוץ למקור מים( | 1
| המערכת מתעוררת ממצב שינה ומבצעת סבב בדיקות לרכיבי המערכת. לאחר הבדיקה שולחת הודעה ומדליקה לד בהתאם לתוצאות הבדיקה. | לאחר לחיצת הכפתור נקבל הודעת SMS ובה מידע על אחוז הסוללה ואם המערכת תקינה. | לחיצה על כפתור המשמש לביצוע בדיקת תקינות של המערכת. | הפעלה יזומה של בדיקת תקינות המערכת בעזרת כפתור ייעודי | 2
| עובד כנדרש | המערכת תזהה מגע עם מים ותעורר ממצב שינה. בשלב זה תתחיל למדוד לחצים. | הכנסת הפרובים למקור מים. | האם המערכת נדלקת כתוצאה מהימצאות במקור מים. | 3
השינוי נובע מהוספת כמה רכיבים שלא נכללו בחישובים | קצת יותר גבוה מהמחושב 15 mA | תואם את החישובים שביצענו. | מדידת צריכת כלל המערכת בעת הכנסת הפרובים למים | בדיקת צריכת אנרגיה של כלל המערכת בכניסה למקור מים | 4
| עובד כנדרש | המערכת תזהה כי נחצה עומק הסף ותפעיל טיימר. לאחר סיום הטיימר תפעיל מנגנונים שונים להצלת הילד | הכנסת המערכת למים מתחת לעומק הסף המוגדר | האם המערכת מצליחה לזהות מקרה טביעה לפי מה שהוגדר | 5
| עובד כנדרש | סיבוב הווסת ושחרור הגז ובסוף סגירה של הווסת | הכנסת המערכת למים מתחת לעומק הסף המוגדר | פתיחת הווסט לשחרור גז ה - 2co וסגירתו | 6
| | קבלת הודעת SMS עובד כנדרש | שליחת SMS לפלאפון מוגדר שיתריע על מקרה הטביעה | שליחת SMS בעת זיהוי טביעה | 7

56

.8.3 נספח :3 ניהול סיכונים

.8.3.1 הקדמה

ניהול הסיכונים בפרויקט יתבצע באופן שוטף לאורך כל הפרויקט. באופן זה ניתן לעקוב אחר מצב הסיכונים העדכני בפרויקט.

ניהול הסיכונים משמש אמצעי חשוב וקריטי שמטרתו להפחית סיכונים קיימים ואפשריים במהלך הפרויקט. ניהול הסיכונים מאפשר זיהוי מוקדם של תקלות פוטנציאליות אפשריות, מתן פתרונות בזמן אמת ומניעת נזקים צפויים.

בניהול סיכונים נבצע זיהוי סיכונים עיקריים בתהליך העבודה, ניתוח הסתברותם להופיע והשפעתם על התהליך. עם זיהוי והערכת הסיכונים נערכת חשיבה מחודשת על מנת להקטין את הסיכונים למינימום האפשרי.

.8.3.2 מחזור ניהול הסיכונים בפרויקט

ניהול סיכונים הינו תהליך מובנה במסגרת מוגדרת של עבודה שוטפת בפרויקט. מעורבים בו הסטודנטים שעובדים על הפרויקט וכן גם המנחה.

תהליך ניהול הסיכונים כולל:

- זיהוי והערכת סיכונים
- קביעת פעולות מונעות ושיטות ופתרונות להורדת הסיכון
- פיקוח ובקרה על אופן הטיפול בסיכונים וחוזר חלילה.

.8.3.3 זיהוי והערכת סיכונים

זיהוי הסיכונים יעשה בשיתוף הסטודנטים והמנחה של הפרויקט. כל אחד יעלה את הסיכונים שלדעתו עלולים להופיע במהלך העבודה על הפרויקט.

על מנת לקבל חיווי כמותי של חומרת הסיכונים מחושבת החומרה של כל סיכון בהתאם לנוסחה הבאה:

חומרת הסיכון = הסתברות הסיכון לקרות X נזק

כלומר, חומרת הסיכון היא המכפלה של נזק בעקבות הסיכון בהסתברות שהסיכון אכן יקרה.

מדדי נזק - נמדד בין הערכים 1-4 כש0- הוא ללא נזק ואילו 4 הוא הנזק החמור ביותר.

מדדי ההסתברות - ההסתברות נמדדת בין הערכים 1-4 כש0- היא ההסתברות הנמוכה מאוד ביותר ואילו 4 היא ההסתברות הגבוהה ביותר.

המכפלות בין מדדי הנזק ומדדי ההסתברות עבור כל סיכון מוצגות בצבעי רמזור - אדום, צהוב, ירוק כשהצבע האדום מסמן חומרת סיכון גבוה והצבע הירוק מסמן חומרת סיכון נמוך.

57

.8.3.4 קביעת פעולות מונעות, שיטות ופתרונות להורדת הסיכון

לאחר שהסיכון זוהה ובוצעה הערכה שלו מבחינת הסתברות ונזק, יש לקבוע פתרונות בתהליך העבודה שימנעו נזקים במידה והסיכון יתממש. הפתרונות צריכים להקיף תהליכים קרובים ביותר לסיכוי שבהם הסיכון יתרחש.

כדאי להקטין הסיכון. ננסה לבצע כמה פעולות:

.1 הקטנת ההסתברות שהסיכון יקרה.

.2 הקטנת השפעתו של הסיכון על הפרויקט.

.3 ביצוע שתי הפעולות יחד.

כל הפתרונות יהיו מתועדים וימצאו במעקב כך שניתן יהיה לבדוק את יעילותם והגנתם מפני התרחשות הסיכון.

טבלה מס' 1 - קביעת רמת / עוצמת הסיכון
הסתברות 1 - זניח 2 - נמוכה 3 - בינונית 4 - גבוהה
4 - חמור 4 8 12 16 | נזק
3 - בינוני 3 6 9 12
2 - מועט 2 4 6 8
1 - קל 1 2 3 4

טבלה מס' 2 - קריטריונים לקביעת הסתברות / סבירות להתרחשות הסיכון
הסתברות / סבירות לסיכון הסבר 4 - גבוהה עלול להתרחש בכל עת. 3 - בינונית קיימת סבירות גבוהה לסיכון. יכול לקרות כמה פעמים.
2 - נמוכה עלול להתרחש לעיתים רחוקות.
1 - זניחה עלול להתרחש לעיתים רחוקות אך כנראה לא תתרחש אף פעם.

טבלה מס' 3 - קריטריונים לקביעת חומרת הסיכון
| נזק הסבר
קיימת השפעה על הלו"ז ופגיעה ביעדי הפרויקט. לא תתאפשר עמידה בביצועים הנדרשים למרות שננקטו הפעילויות הנדרשות. | 4 - חמור
תגרם הפחתת ביצועים ברמה בינונית במידה והנושא לא יטופל. נדרשת פעילות נוספת על מנת לעמוד בלו"ז. | 3 - בינוני
קיימת השפעה מועטה על ביצוע תהליך העבודה. קיימת אפשרות של ביצוע שינויים מזעריים בתכנון ובתהליך העבודה למניעת פגיעה בלו"ז. | 2 - מועט
| 1 - קל ההשפעה על תהליך העבודה תהיה נמוכה מאד או בכלל לא ומכאן שלא תהיה פגיעה בפרויקט.

58

.8.3.5 טבלת ניהול סיכונים:

שארית סיכון | התמודדות / הקטנת הסיכון | רמת חומרה | חומרה 0-16 | נזק 1-4 | הסתברות 1-4 | | | | # תיאור סיכון תחום משמעות
3 | *בחירת רכיבים אמינים בעלי ביקורות טובות ושהוכיחו את עצמם בשוק *שימוש ברכיב תוך כדי חיפוש חלופה *קנייה של כמה רכיבים מאותו סוג )ספיירים( | | | | 1 4 4 בינונית | חיפוש חלופה - רכיב אחר | | חוסר התאמה בין רכיבים לבין נתוני המפרט שלהם | 1
4 | *בחירת רכיבים אמינים בעלי ביקורות טובות ושהוכיחו את עצמם בשוק *חידוד והבנת ערכי סף של רכיבים שונים, כמו מתח וזרם מקסימלי *קנייה של כמה רכיבים מאותו סוג )ספיירים( | | | | 3 2 6 בינונית | חיפוש חלופה - רכיב אחר | | תקלות רכיבים בזמן בדיקות | 2
6 *חיפוש מידע בפורומים שונים | *התייעצות עם בעל מקצוע - מומחה | | | | 2 4 8 בינונית | למידת הנושא בצורה יותר מעמיקה | | | 3 עיכובים בפיתוח התוכנה
8 | *בדיקה מקיפה של הרכיבים לפני הקנייה, במבט על כלל המערכת *נגדיר טווחים מדויקים באלגוריתם הזיהוי על מנת לעמוד באחוזי השגיאה הדרושים | | | | 3 4 12 גבוהה | *בדיקת הגורמים לבעיה *תיקון התכנון *בדיקות נוספות | | אי עמידת המערכת בדרישות האפיון | 4
1 *תיעוד מפורט לשימור ידע | *חפיפה ושיתוף ידע בין הסטודנטים | | | | | אי עמידה בלו"ז 2 1 2 נמוכה | ניהולי | מחלה של אחד הסטודנטים | 5
2 | *שינוי לוח הזמנים ברגע קבלת הצו לצמצום העיכוב. *לנסות לבטל צווי מילואים | | | | | | 6 מילואים אי עמידה בלו"ז 2 3 6 בינונית
4 *תיעוד מפורט לשימור ידע | *חפיפה ושיתוף ידע בין הסטודנטים | | | | | אי עמידה בלו"ז 1 4 4 בינונית | | עזיבת כוח אדם בפרויקט )סטודנט או מנחה( | 7

טכני

59

.8.4 נספח :4 גאנט
